swiszczoo/adat_usb_interface/gfx/overlay.png

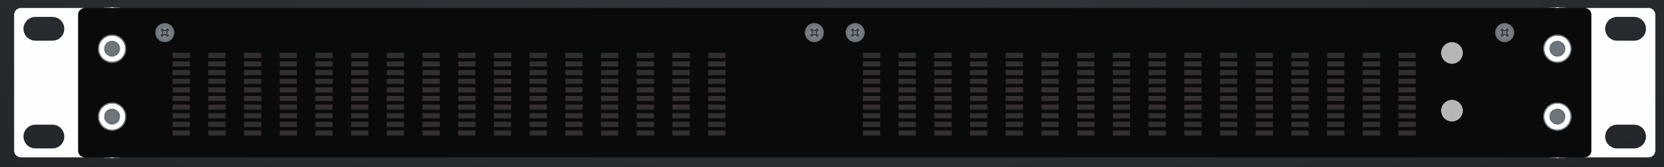
gfx/overlay.png
