swiszczoo/adat_usb_interface/cad/assembly.FCStd

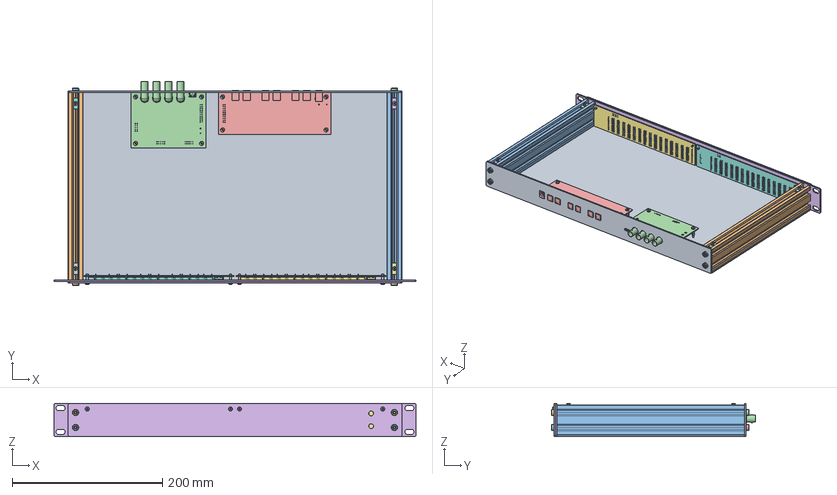
[picture p2: CAD file, 2025-11-25]
cad/assembly.FCStd
482.6 x 272.0 x 44.5 mm
bottom
vslot_2040_vslot_2040_250_001
vslot_2040_vslot_2040_250_002
tee_nut_Tee Nut_001
tee_nut_Tee Nut_002
tee_nut_Tee Nut_003
tee_nut_Tee Nut_004
M3x8-Śruba
M3x8-Śruba_001
M3x8-Śruba_002
M3x8-Śruba_003
spacer_10+6_spacer_10+6_001
spacer_10+6_spacer_10+6_002
spacer_10+6_spacer_10+6_003
spacer_10+6_spacer_10+6_004
spacer_10+6_spacer_10+6_005
spacer_10+6_spacer_10+6_006
spacer_10+6_spacer_10+6_007
spacer_10+6_spacer_10+6_008
main-board_001
supply-board_001
M3x8-Śruba001_001
M3x8-Śruba001_002
M3x8-Śruba001_003
M3x8-Śruba001_004
M3x8-Śruba001_005
M3x8-Śruba001_006
M3x8-Śruba001_007
M3x8-Śruba001_008
tee_nut_Tee Nut_005
tee_nut_Tee Nut_006
tee_nut_Tee Nut_007
tee_nut_Tee Nut_008
M3x8-Śruba_004
M3x8-Śruba_005
M3x8-Śruba_006
M3x8-Śruba_007
front_plate_front_plate_001
display-board_001
display-board_002
back_plate
M5x16-Śruba
M5x16-Śruba_001
M5x16-Śruba_002
M5x16-Śruba_003
front_acrylic
M5x16-Śruba_004
M5x16-Śruba_005
M5x16-Śruba_006
M5x16-Śruba_007
M3x12-Śruba_001
M3x12-Śruba_002
M3x12-Śruba_003
M3x12-Śruba_004
