swiszczoo/adat_usb_interface/cad/main-board.FCStd

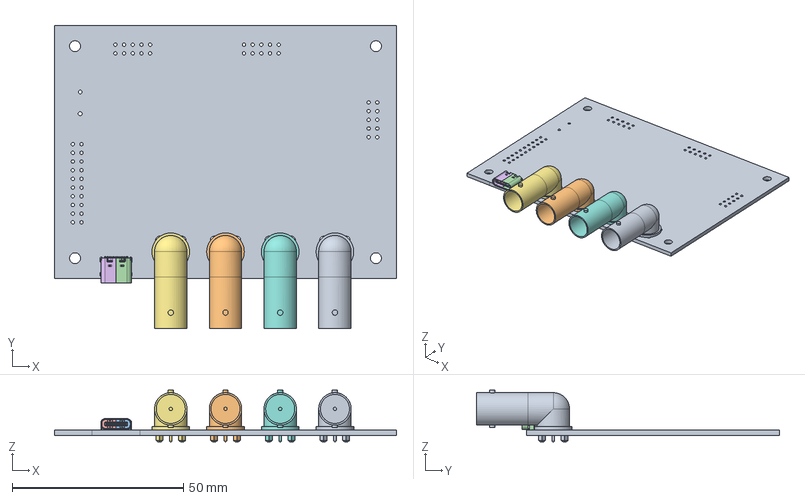
[picture p3: CAD file, 2025-11-04]
cad/main-board.FCStd
100.0 x 88.5 x 15.2 mm
DOSIN_801_0051
DOSIN_801_0052
USB_C_Receptacle_GCT_USB4105-xx-A_16P_TopMnt_Horizontal
USB_C_Receptacle_GCT_USB4105-xx-A_16P_TopMnt_Horizontal001
USB_C_Receptacle_GCT_USB4105-xx-A_16P_TopMnt_Horizontal002
USB_C_Receptacle_GCT_USB4105-xx-A_16P_TopMnt_Horizontal003
USB_C_Receptacle_GCT_USB4105-xx-A_16P_TopMnt_Horizontal004
USB_C_Receptacle_GCT_USB4105-xx-A_16P_TopMnt_Horizontal005
USB_C_Receptacle_GCT_USB4105-xx-A_16P_TopMnt_Horizontal006
USB_C_Receptacle_GCT_USB4105-xx-A_16P_TopMnt_Horizontal007
USB_C_Receptacle_GCT_USB4105-xx-A_16P_TopMnt_Horizontal008
USB_C_Receptacle_GCT_USB4105-xx-A_16P_TopMnt_Horizontal009
USB_C_Receptacle_GCT_USB4105-xx-A_16P_TopMnt_Horizontal010
USB_C_Receptacle_GCT_USB4105-xx-A_16P_TopMnt_Horizontal011
USB_C_Receptacle_GCT_USB4105-xx-A_16P_TopMnt_Horizontal012
USB_C_Receptacle_GCT_USB4105-xx-A_16P_TopMnt_Horizontal013
USB_C_Receptacle_GCT_USB4105-xx-A_16P_TopMnt_Horizontal014
USB_C_Receptacle_GCT_USB4105-xx-A_16P_TopMnt_Horizontal015
USB_C_Receptacle_GCT_USB4105-xx-A_16P_TopMnt_Horizontal016
USB_C_Receptacle_GCT_USB4105-xx-A_16P_TopMnt_Horizontal017
USB_C_Receptacle_GCT_USB4105-xx-A_16P_TopMnt_Horizontal018
USB_C_Receptacle_GCT_USB4105-xx-A_16P_TopMnt_Horizontal019
USB_C_Receptacle_GCT_USB4105-xx-A_16P_TopMnt_Horizontal020
USB_C_Receptacle_GCT_USB4105-xx-A_16P_TopMnt_Horizontal021
USB_C_Receptacle_GCT_USB4105-xx-A_16P_TopMnt_Horizontal022
USB_C_Receptacle_GCT_USB4105-xx-A_16P_TopMnt_Horizontal023
USB_C_Receptacle_GCT_USB4105-xx-A_16P_TopMnt_Horizontal024
USB_C_Receptacle_GCT_USB4105-xx-A_16P_TopMnt_Horizontal025
USB_C_Receptacle_GCT_USB4105-xx-A_16P_TopMnt_Horizontal026
USB_C_Receptacle_GCT_USB4105-xx-A_16P_TopMnt_Horizontal027
USB_C_Receptacle_GCT_USB4105-xx-A_16P_TopMnt_Horizontal028
USB_C_Receptacle_GCT_USB4105-xx-A_16P_TopMnt_Horizontal029
USB_C_Receptacle_GCT_USB4105-xx-A_16P_TopMnt_Horizontal030
USB_C_Receptacle_GCT_USB4105-xx-A_16P_TopMnt_Horizontal031
USB_C_Receptacle_GCT_USB4105-xx-A_16P_TopMnt_Horizontal032
USB_C_Receptacle_GCT_USB4105-xx-A_16P_TopMnt_Horizontal033
USB_C_Receptacle_GCT_USB4105-xx-A_16P_TopMnt_Horizontal034
USB_C_Receptacle_GCT_USB4105-xx-A_16P_TopMnt_Horizontal035
DOSIN_801_0053
DOSIN_801_0054
main-board_PCB
