swiszczoo/adat_usb_interface/cad/bottom_plate.FCStd

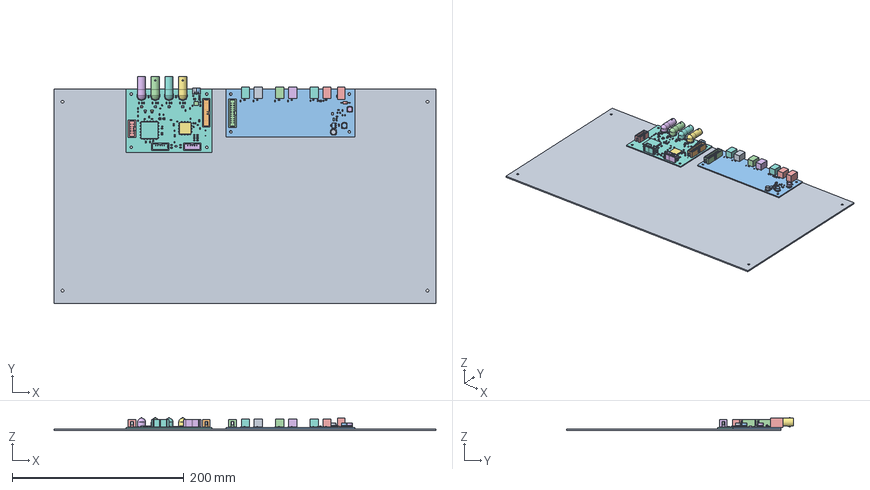
[picture p4: CAD file, 2025-11-25]
cad/bottom_plate.FCStd
445.0 x 264.5 x 15.2 mm
bottom_plate
C_0805_2012Metric
C_Elec_6.3x5.4
C_Elec_6.3x5.005
C_0805_2012Metric001
C_0805_2012Metric002
SOT-23-6
C_1206_3216Metric
L_1210_3225Metric
C_0805_2012Metric003
R_0805_2012Metric
R_0805_2012Metric001
CUI_PJ002A
C_Elec_6.3x5.007
C_Elec_6.3x5.008
PLx237
C_0805_2012Metric004
C_0805_2012Metric005
SOT-223
C_0805_2012Metric006
C_0805_2012Metric007
L_0805_2012Metric
R_0805_2012Metric002
R_0805_2012Metric003
R_0805_2012Metric004
R_0805_2012Metric005
C_0805_2012Metric008
IDC-Header_2x10_P2.54mm_Vertical
PLx238
C_1206_3216Metric001
L_0805_2012Metric001
PLx239
PLx240
C_1206_3216Metric002
SOT-563
PLx241
D_DO-41_SOD81_P10.16mm_Horizontal
PLx242
R_0805_2012Metric006
C_0805_2012Metric009
C_Elec_6.3x5.010
C_Elec_6.3x5.011
supply-board_PCB
C_0805_2012Metric010
C_0805_2012Metric011
R_0805_2012Metric007
R_0805_2012Metric008
IDC-Header_2x05_P2.54mm_Vertical
R_0805_2012Metric009
R_0805_2012Metric010
R_0805_2012Metric011
SOT-23-007
LED_0805_2012Metric
DOSIN_801_0051
R_0805_2012Metric012
DOSIN_801_0052
C_1206_3216Metric003
R_0805_2012Metric013
SOT-23-008
C_0805_2012Metric012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
