swiszczoo/adat_usb_interface/cad/back_plate.FCStd

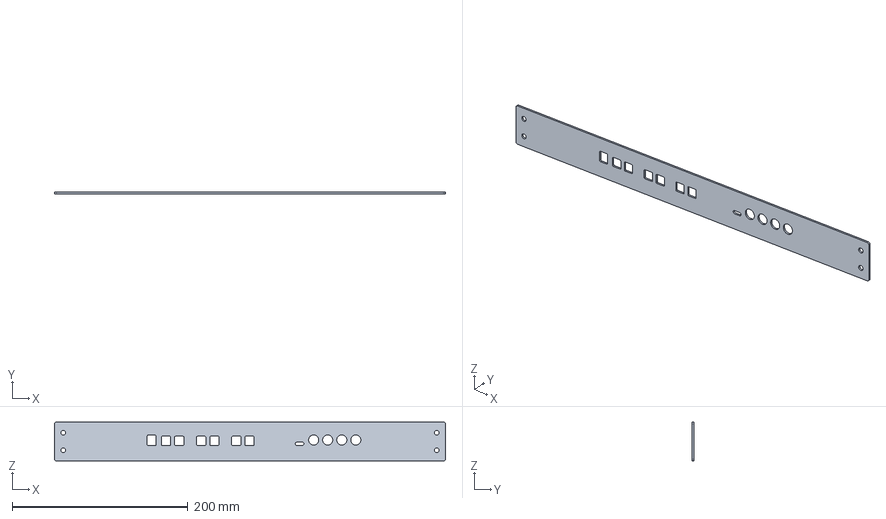
[picture p5: CAD file, 2025-11-25]
cad/back_plate.FCStd
445.0 x 2.00 x 44.0 mm
