swiszczoo/adat_usb_interface/cad/step/display-board.step

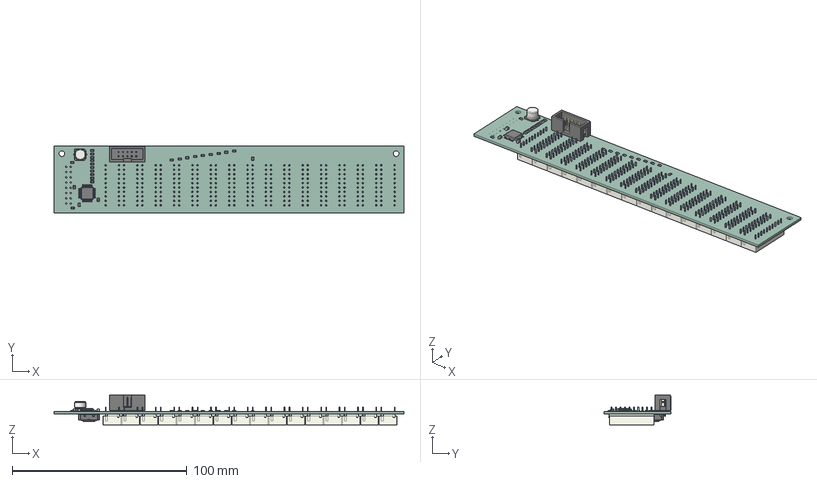
[picture p6: CAD file, 2025-11-04]
cad/step/display-board.step
200.0 x 38.5 x 16.9 mm
R_0805_2012Metric x 22
C_0805_2012Metric x 3
IDC-Header_2x05_P2.54mm_Vertical
C_Elec_6.3x5.4
LQFP-64_7x7mm_P0.4mm
HDSP-4832 x 16
SW_Push_1P1T_NO_CK_PTS125Sx43SMTR x 2
display-board_PCB
