swiszczoo/adat_usb_interface/cad/step/V-Slot 20x40x500 Linear Rail.step

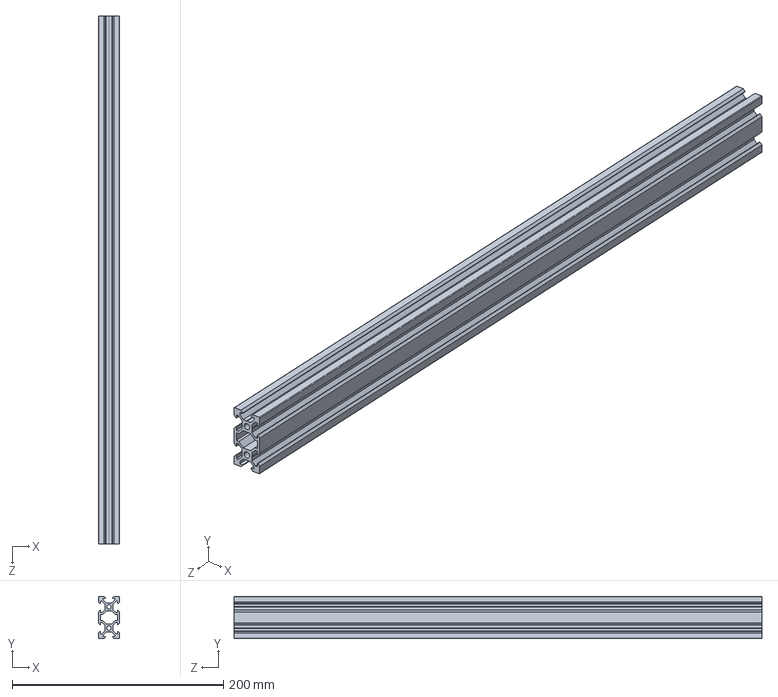
[picture p7: CAD file, 2025-11-04]
cad/step/V-Slot 20x40x500 Linear Rail.step
20.0 x 40.0 x 500.0 mm
