swiszczoo/adat_usb_interface/cad/front_plate.FCStd

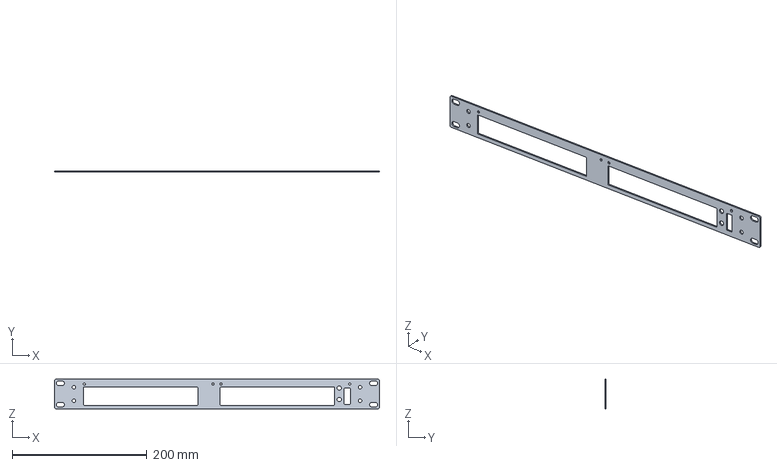
[picture p8: CAD file, 2025-11-25]
cad/front_plate.FCStd
482.6 x 2.00 x 44.0 mm
