swiszczoo/adat_usb_interface/cad/step/supply-board.step

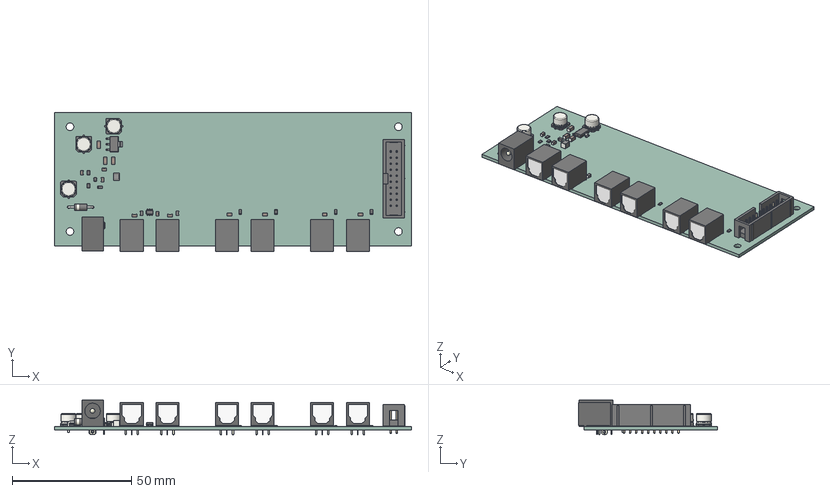
[picture p9: CAD file, 2025-11-04]
cad/step/supply-board.step
150.0 x 58.4 x 14.6 mm
C_0805_2012Metric x 10
C_Elec_6.3x5.4 x 3
SOT-23-6
C_1206_3216Metric x 3
L_1210_3225Metric
R_0805_2012Metric x 7
CUI_PJ002A
PLx237 x 6
SOT-223
L_0805_2012Metric x 2
IDC-Header_2x10_P2.54mm_Vertical
SOT-563
D_DO-41_SOD81_P10.16mm_Horizontal
supply-board_PCB
