swiszczoo/adat_usb_interface/cad/front_acrylic.FCStd

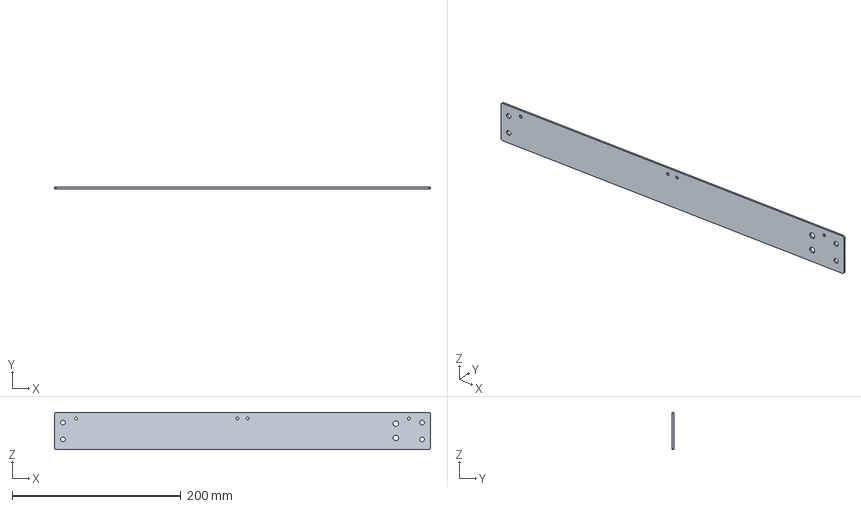
[picture p10: CAD file, 2025-11-25]
cad/front_acrylic.FCStd
445.0 x 2.00 x 44.0 mm
