swiszczoo/adat_usb_interface/cad/step/PLx237.step

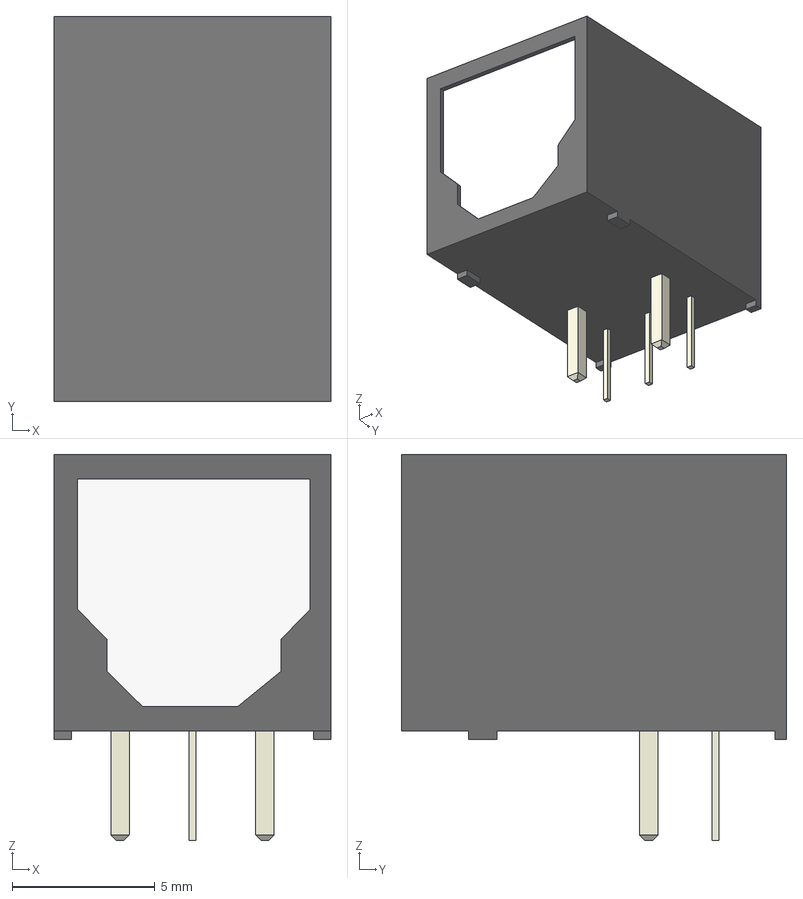
[picture p11: CAD file, 2025-10-09]
cad/step/PLx237.step
9.70 x 13.5 x 13.6 mm
