swiszczoo/adat_usb_interface/cad/step/DOSIN_801_0051.step

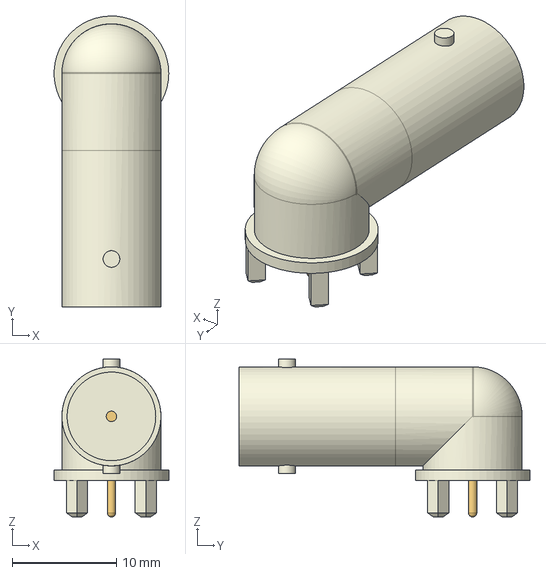
[picture p12: CAD file, 2025-10-09]
cad/step/DOSIN_801_0051.step
11.0 x 27.9 x 15.2 mm
