swiszczoo/adat_usb_interface/cad/top_plate.FCStd

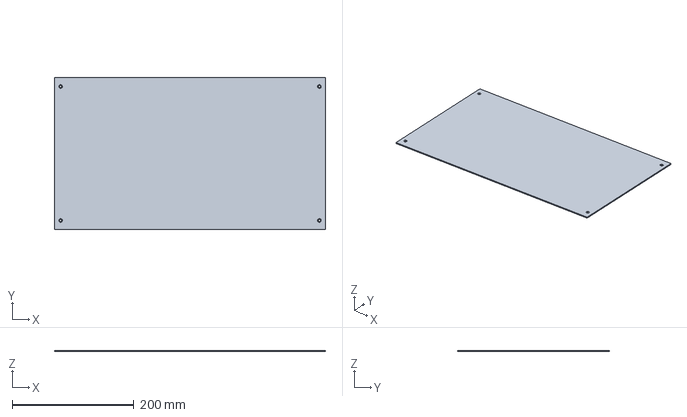
[picture p13: CAD file, 2025-11-04]
cad/top_plate.FCStd
445.0 x 250.0 x 2.00 mm
