swiszczoo/adat_usb_interface/cad/spacer_10+6.FCStd

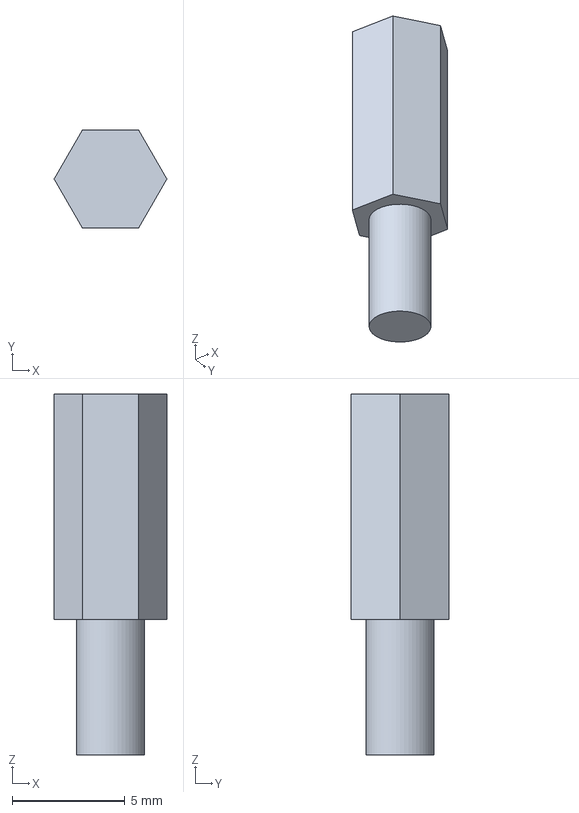
[picture p14: CAD file, 2025-11-04]
cad/spacer_10+6.FCStd
5.00 x 4.33 x 16.0 mm
