swiszczoo/adat_usb_interface/cad/step/CUI_PJ002A.step

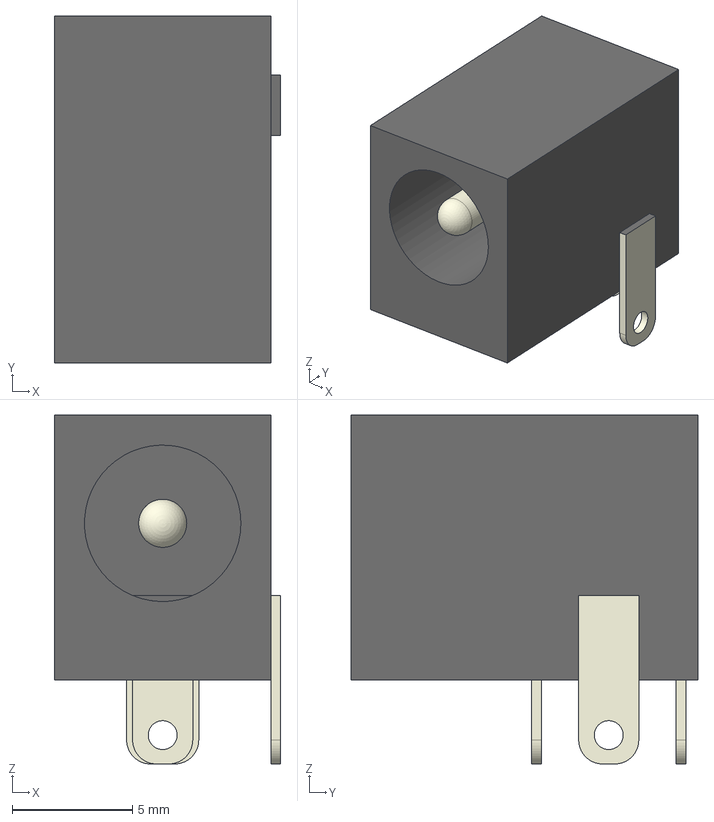
[picture p15: CAD file, 2025-10-09]
cad/step/CUI_PJ002A.step
9.40 x 14.4 x 14.5 mm
