swiszczoo/adat_usb_interface/cad/vslot_2040_250.FCStd

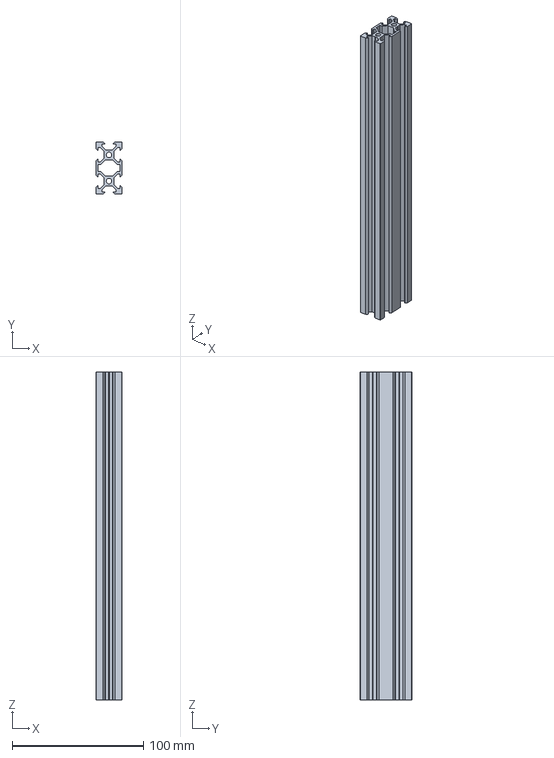
[picture p16: CAD file, 2025-11-04]
cad/vslot_2040_250.FCStd
20.0 x 40.0 x 250.0 mm
