swiszczoo/adat_usb_interface/cad/step/Tee Nut.step

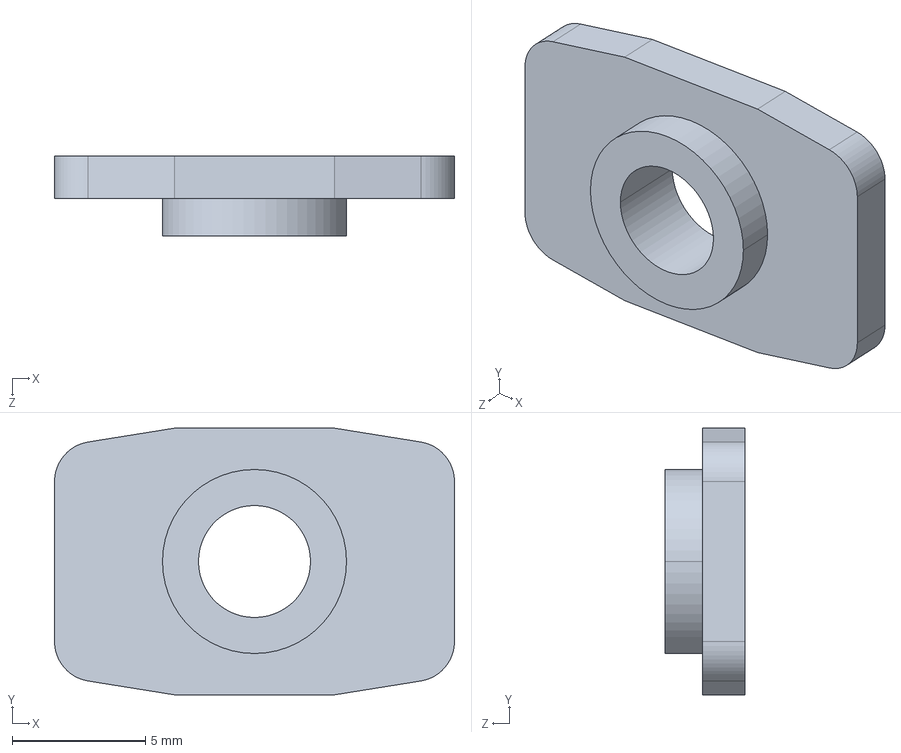
[picture p17: CAD file, 2025-11-04]
cad/step/Tee Nut.step
15.0 x 10.0 x 3.00 mm
