swiszczoo/adat_usb_interface/(list of files, cad)

Other CAD files:
cad/CUI_PJ002A.FCStd
cad/DOSIN_801_0051.FCStd
cad/PLx237.FCStd
cad/display-board.FCStd
cad/supply-board.FCStd
cad/tee_nut.FCStd
