swiszczoo/adat_usb_interface/pcb/pdf/adatv2.pdf

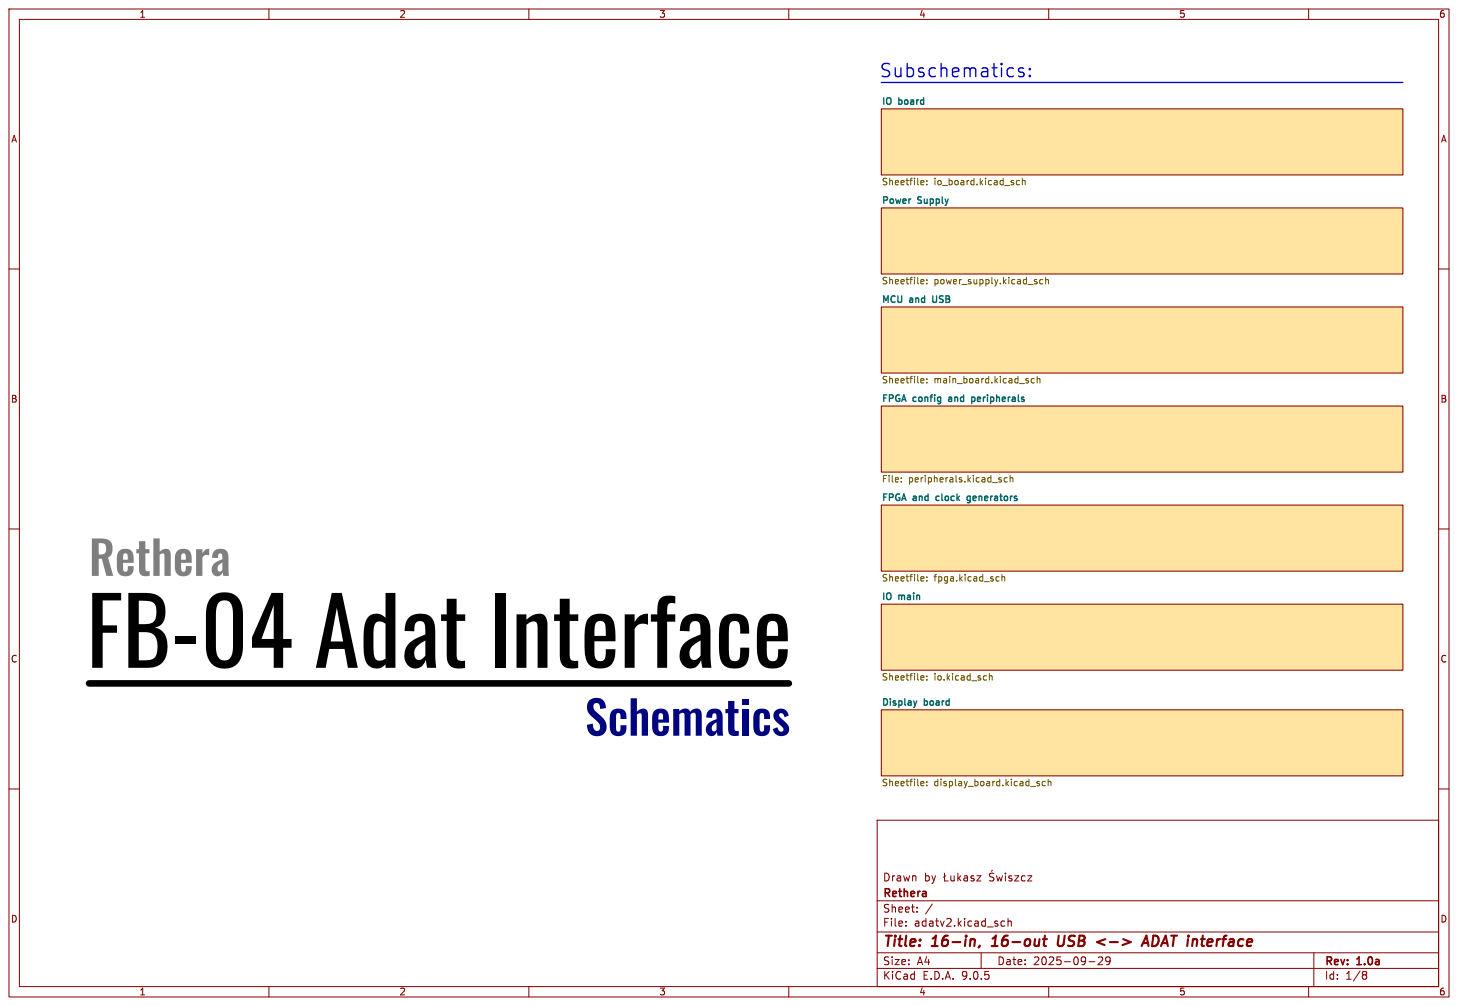
[picture p18: page 1]

FPGA config and peripherals File: peripherals.kicad_sch

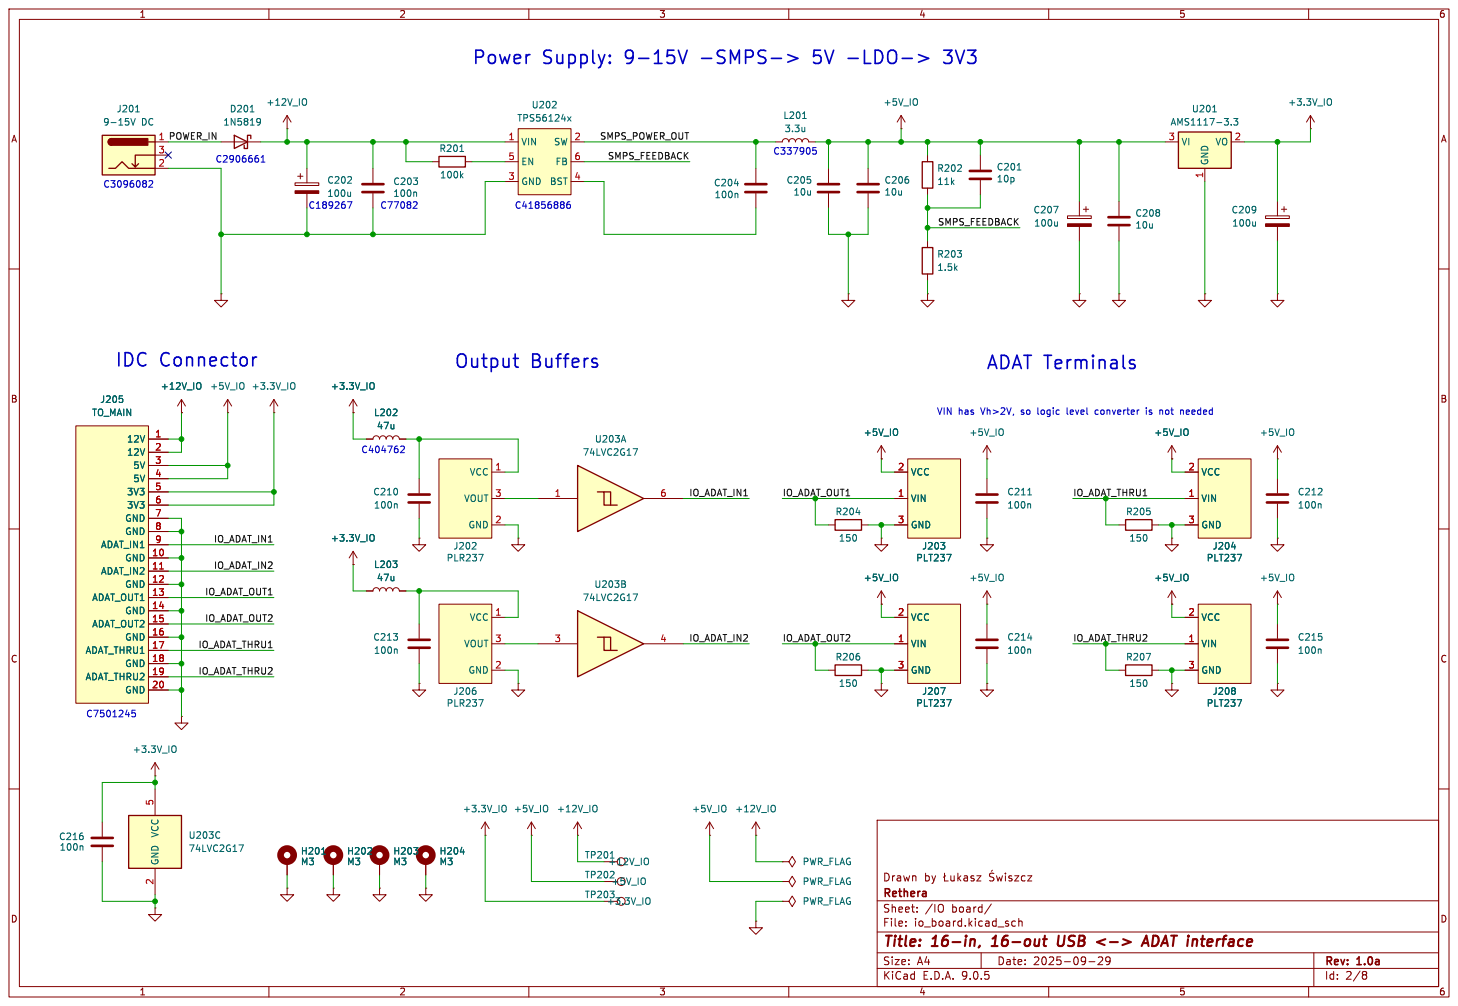
[picture p19: page 2]

3V3 6 GND 7 GND 8 ADAT_IN1 9 GND 10 ADAT_IN2 11 GND 12 ADAT_OUT1 13 GND 14 ADAT_OUT2 15 GND 16 ADAT_THRU1 17 GND 18 ADAT_THRU2 19 GND 20

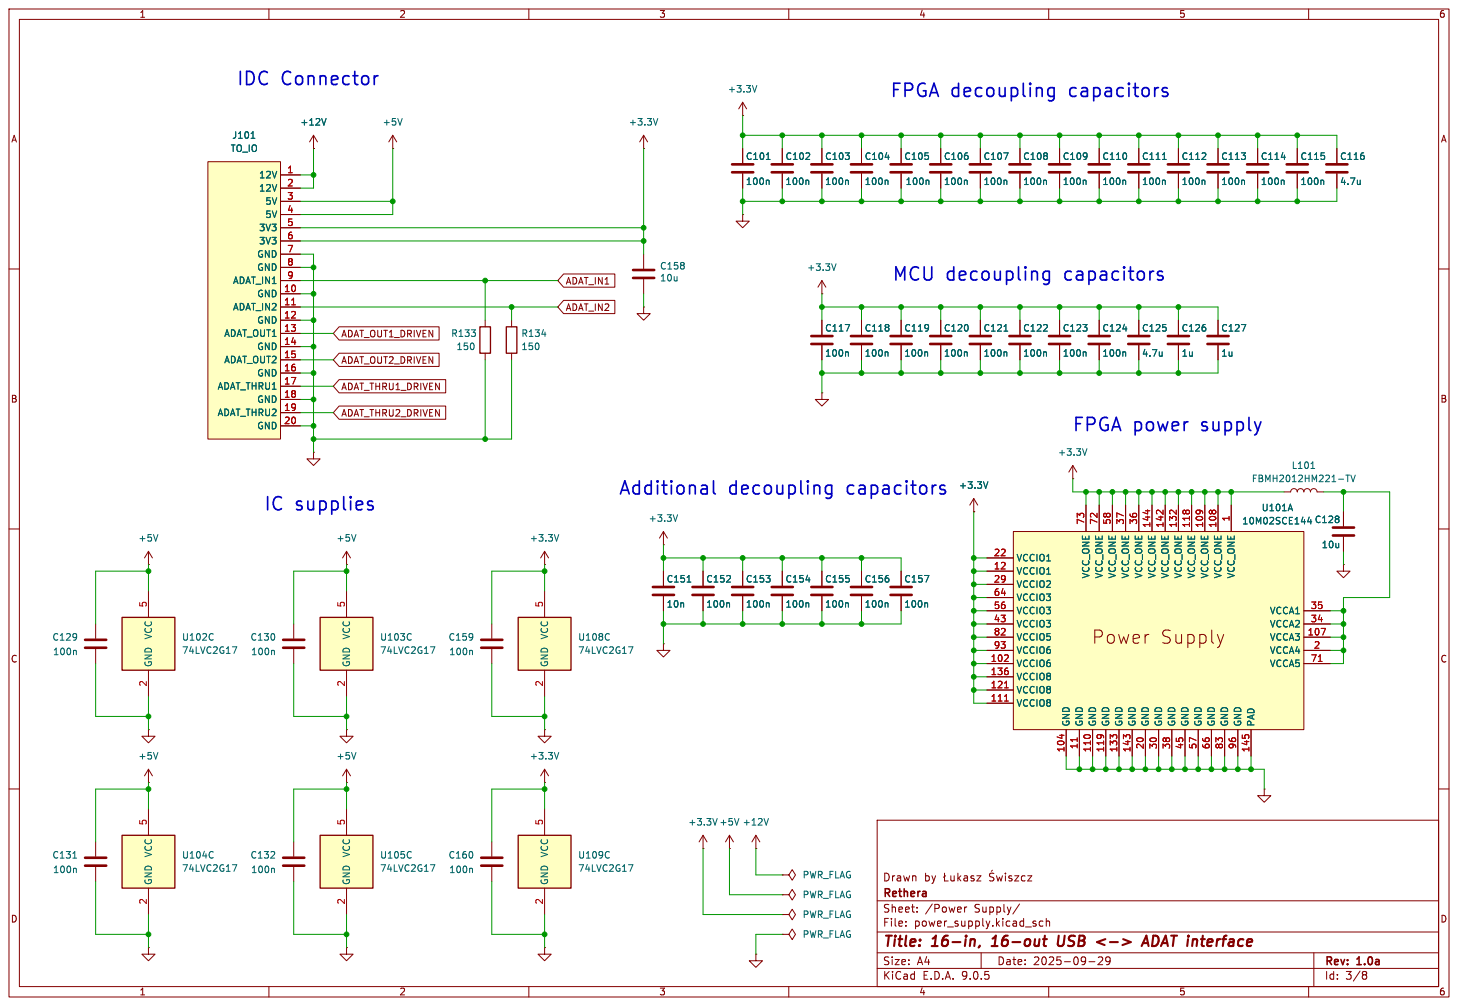
[picture p20: page 3]

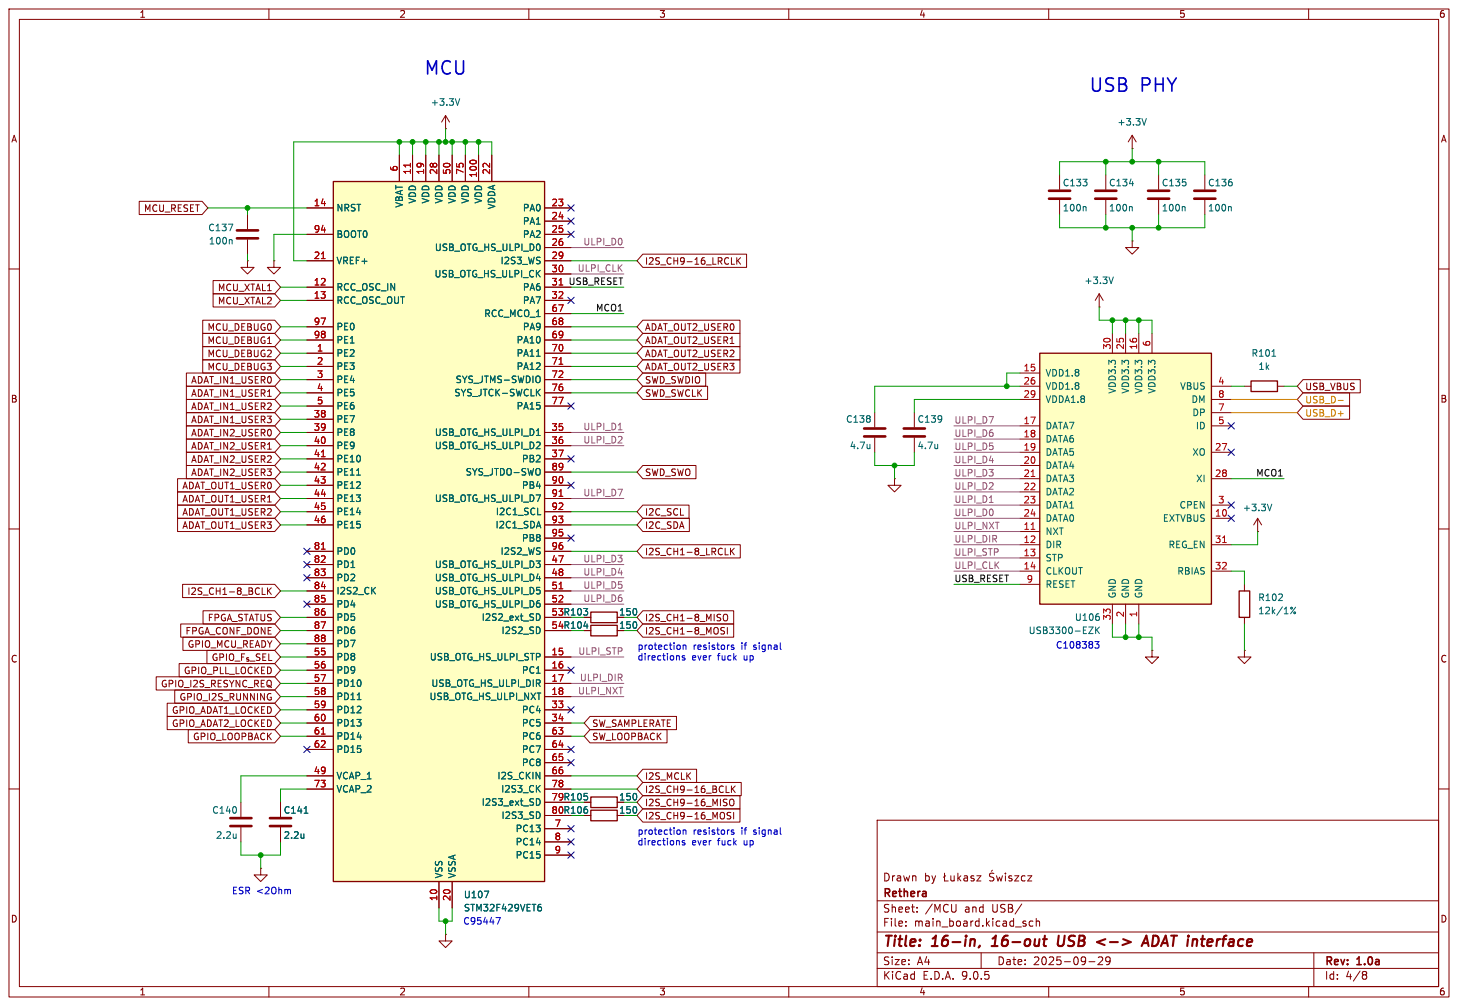
[picture p21: page 4]

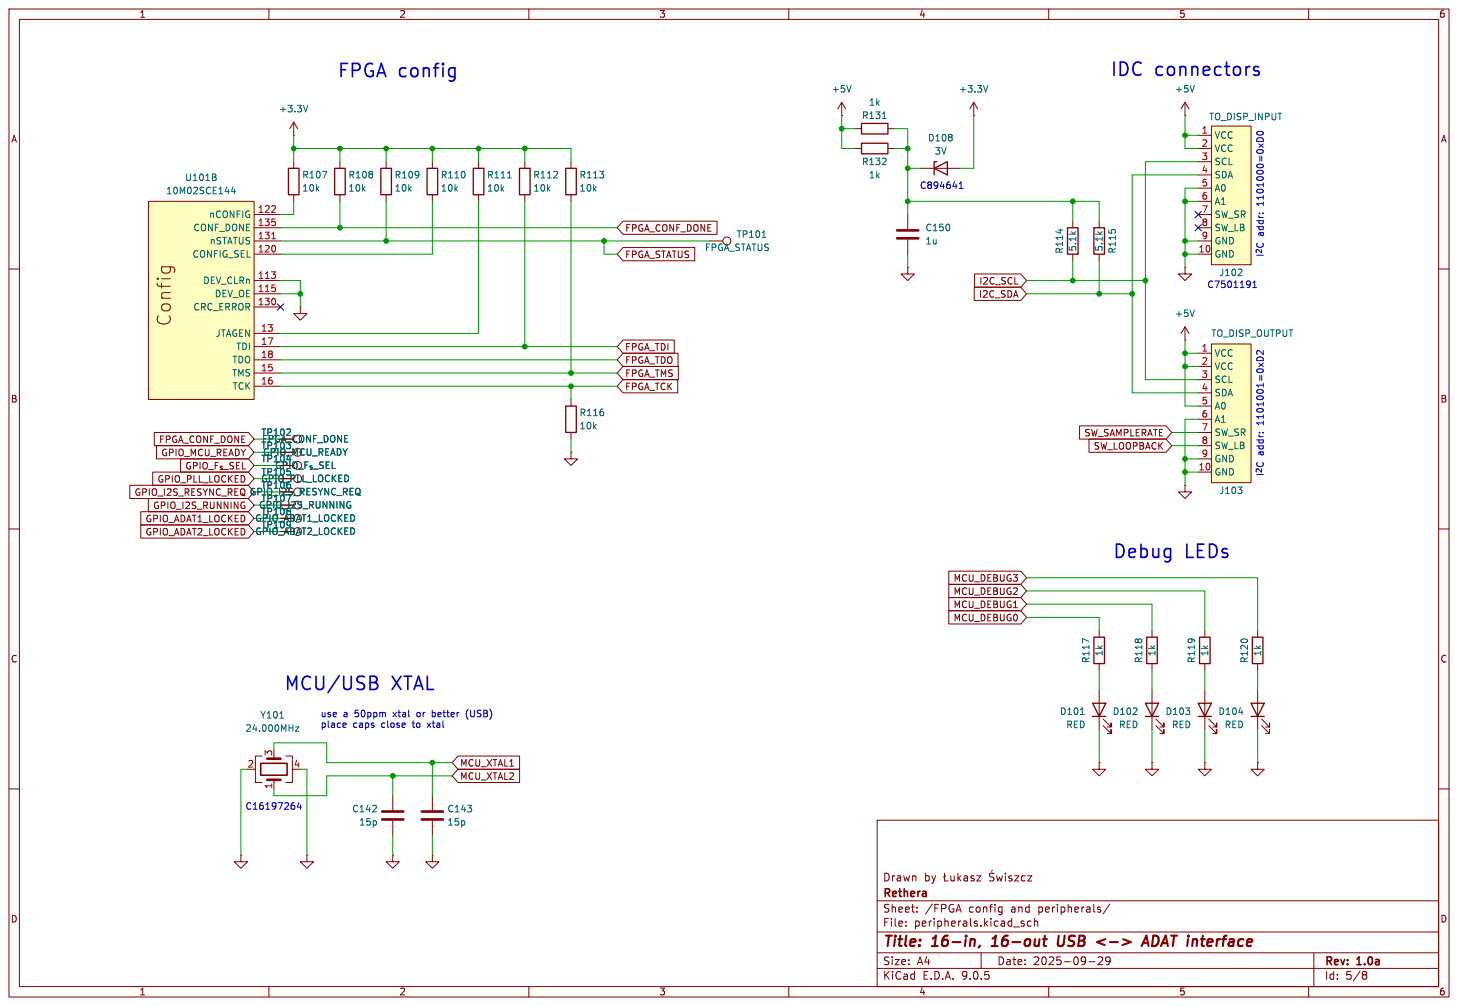
[picture p22: page 5]

use a 50ppm xtal or better (USB)

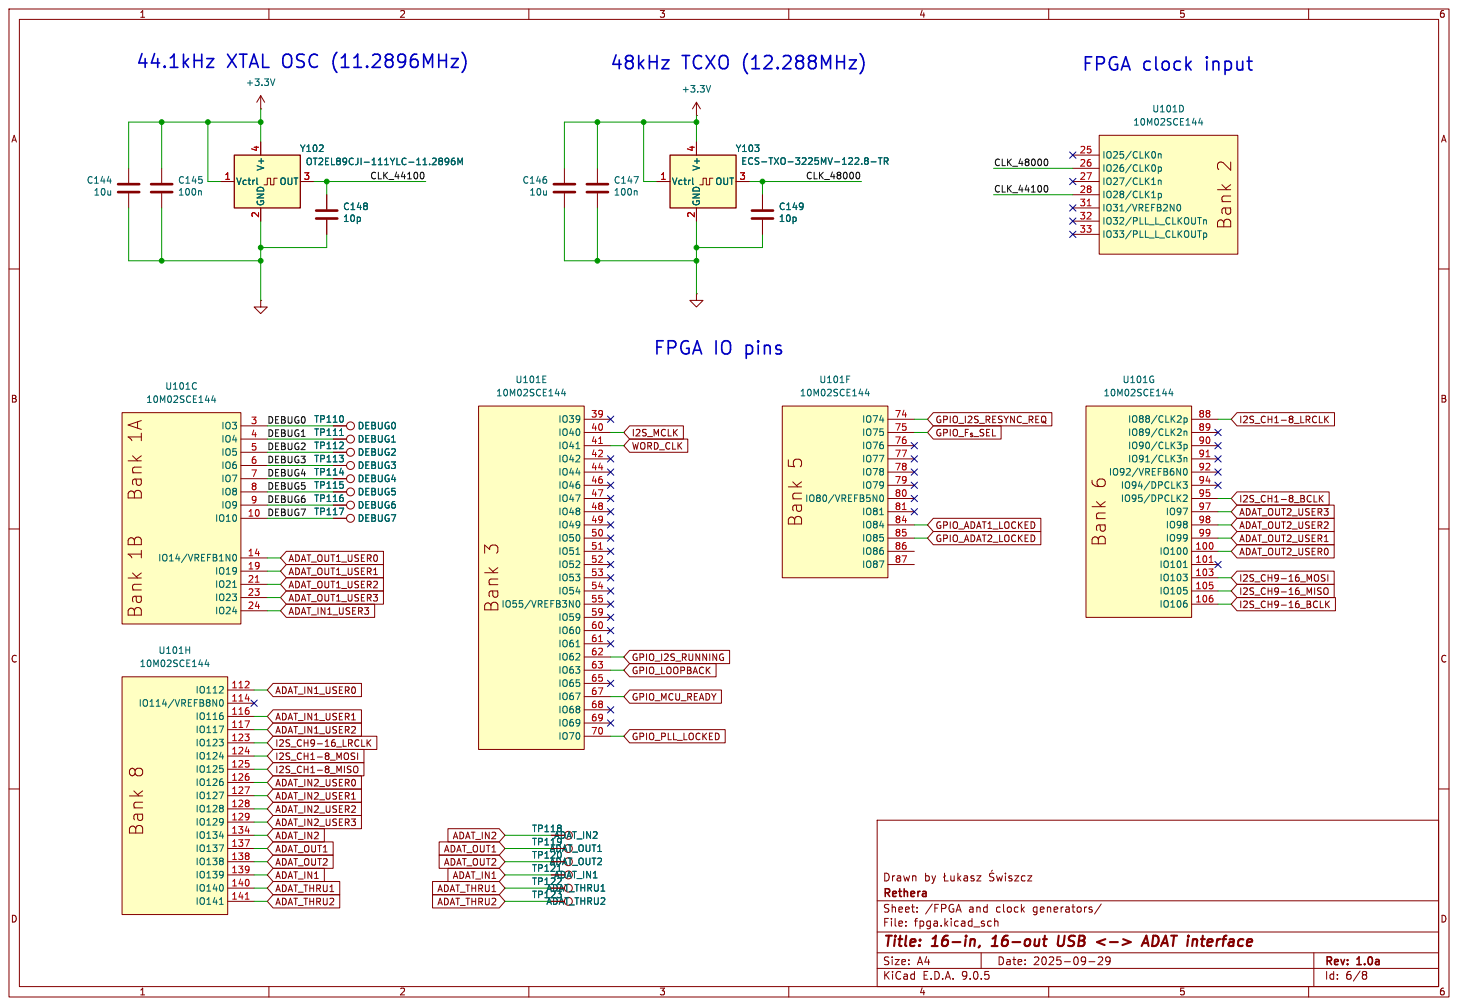
[picture p23: page 6]

2 OUT 3Y103 ECS-TXO-3225MV-122.8-TR

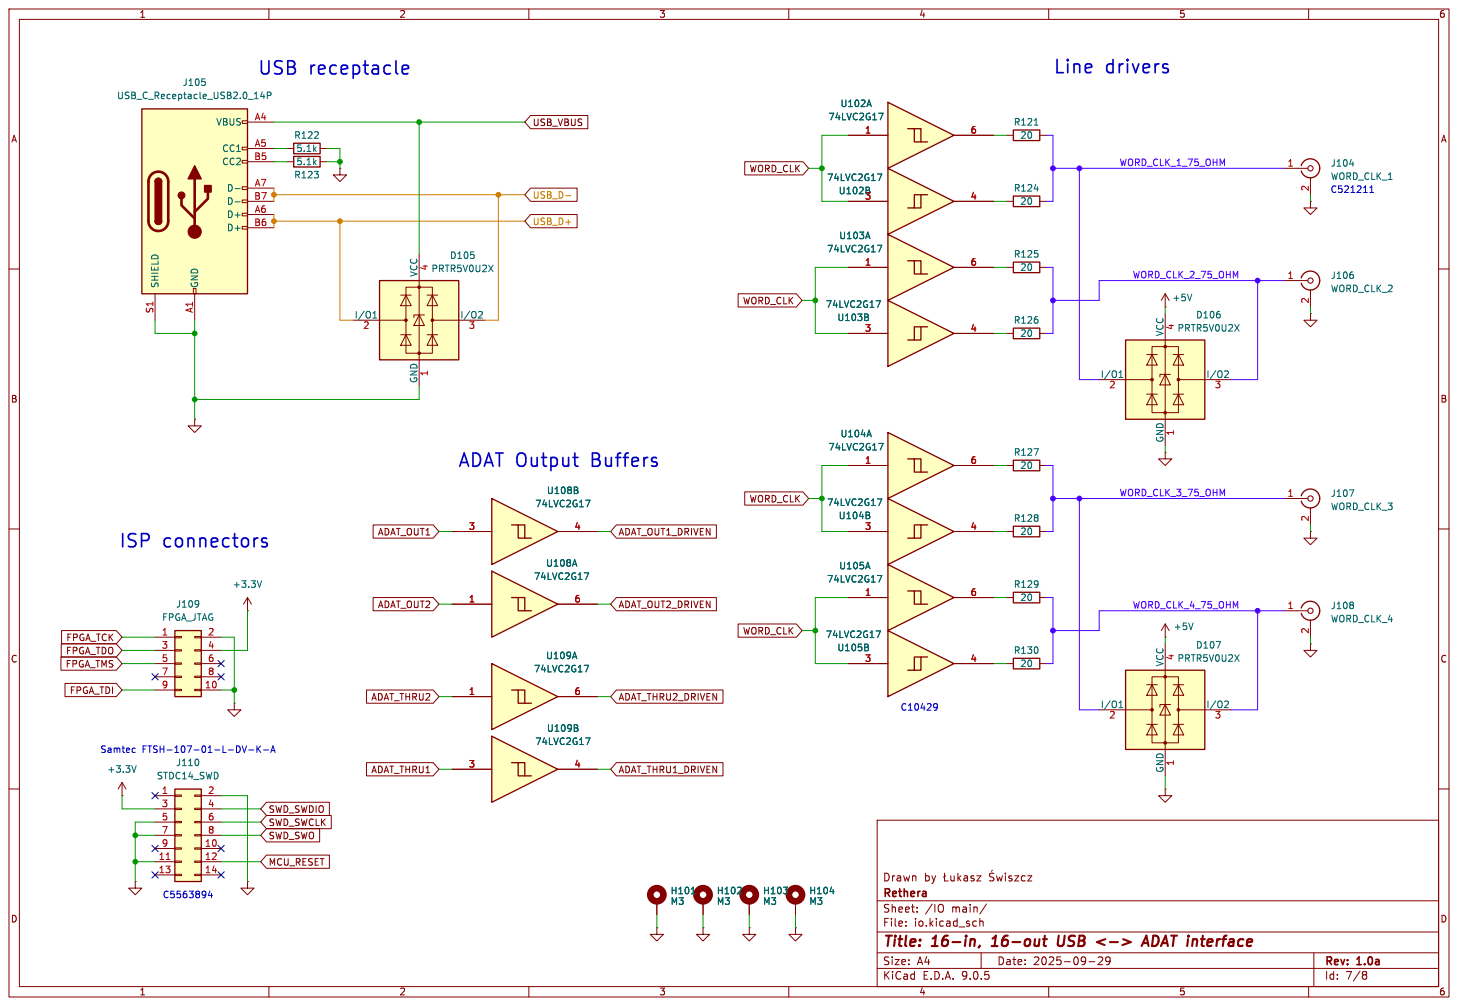
[picture p24: page 7]

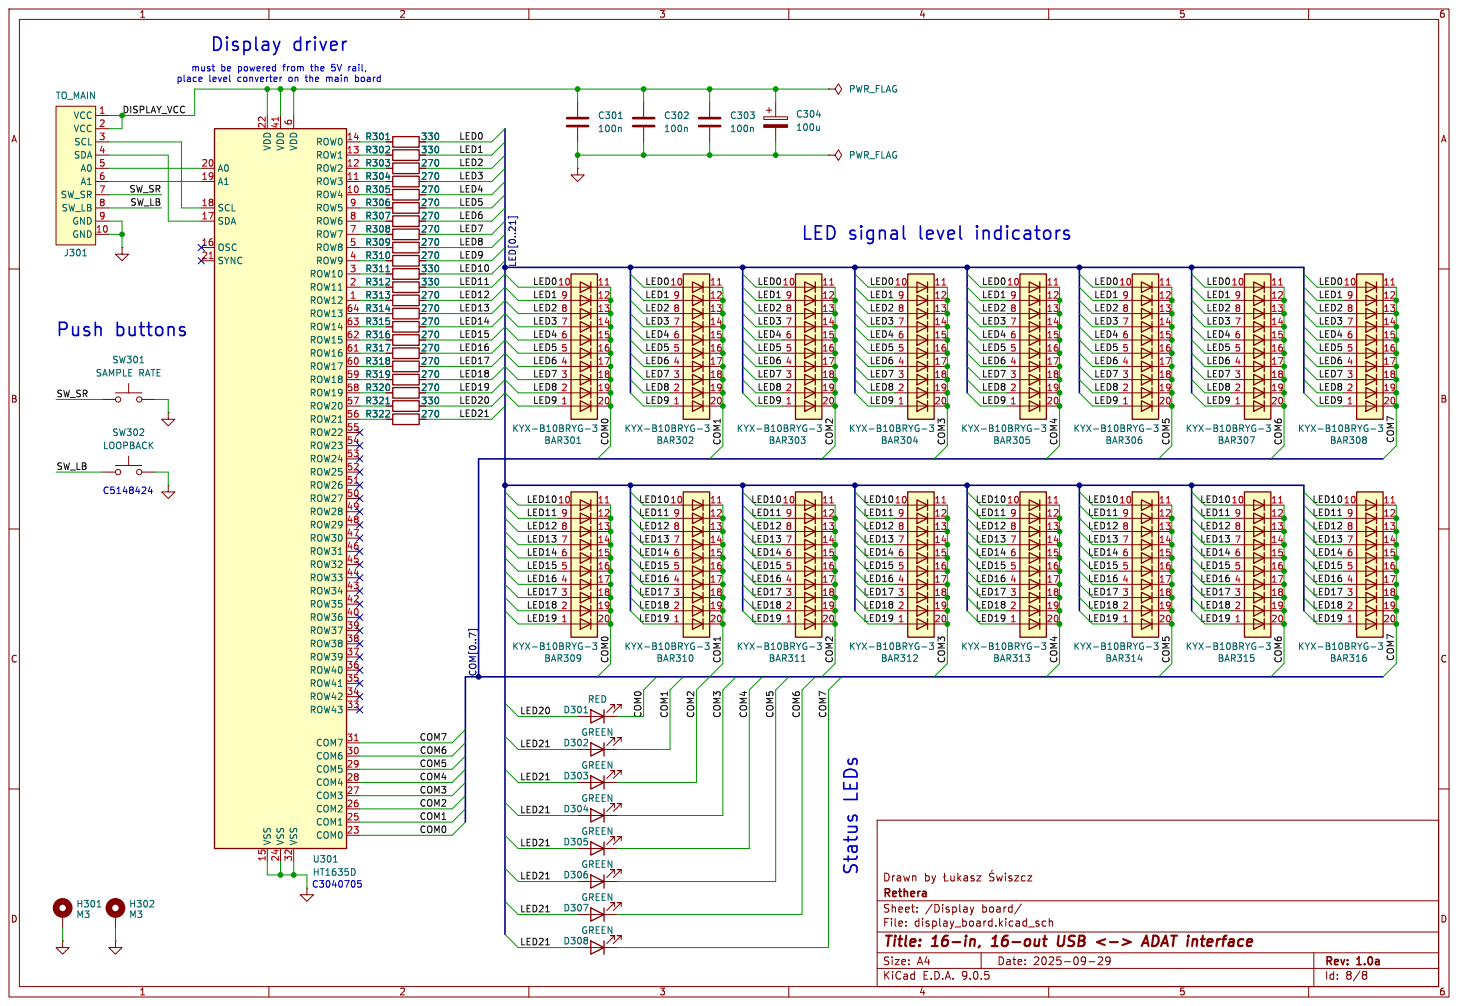
[picture p25: page 8]
