swiszczoo/adat_usb_interface/pcb/adatv2.kicad_pcb

## KiCad design pcb/adatv2.kicad_pcb (2025-10-10)

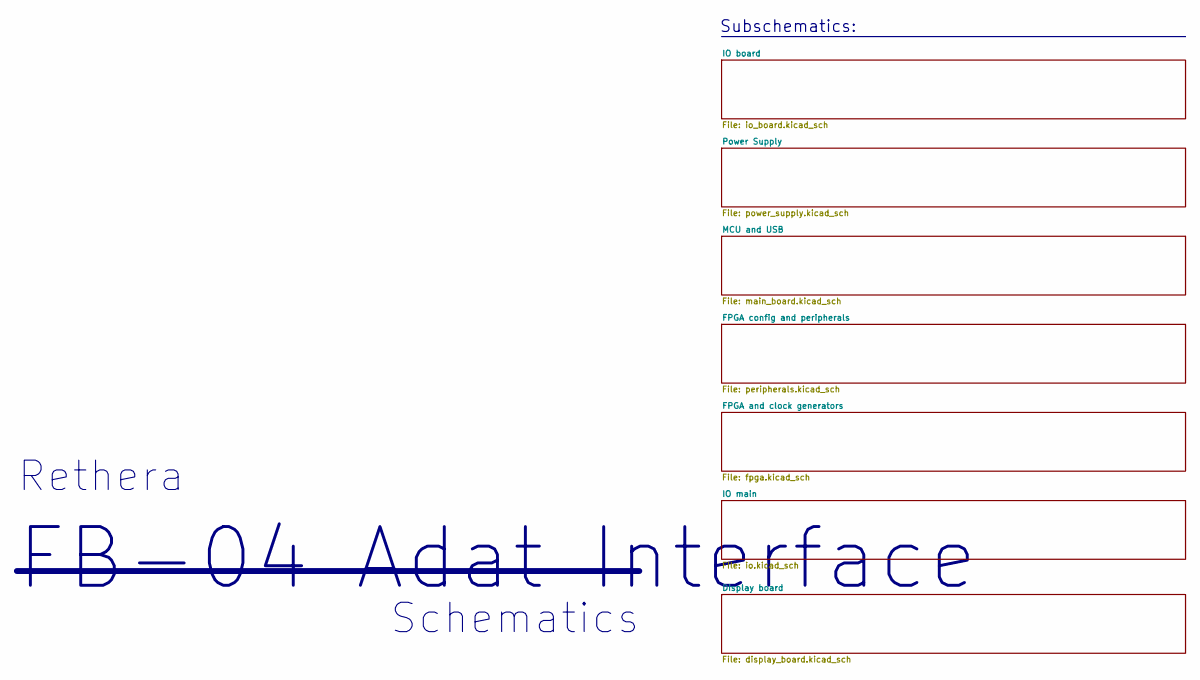
[picture p26: schematic adatv2.kicad_sch, 16-in, 16-out USB <-> ADAT interface]

Notes on the sheet:
Subschematics:
FB-04 Adat Interface
Schematics
Rethera

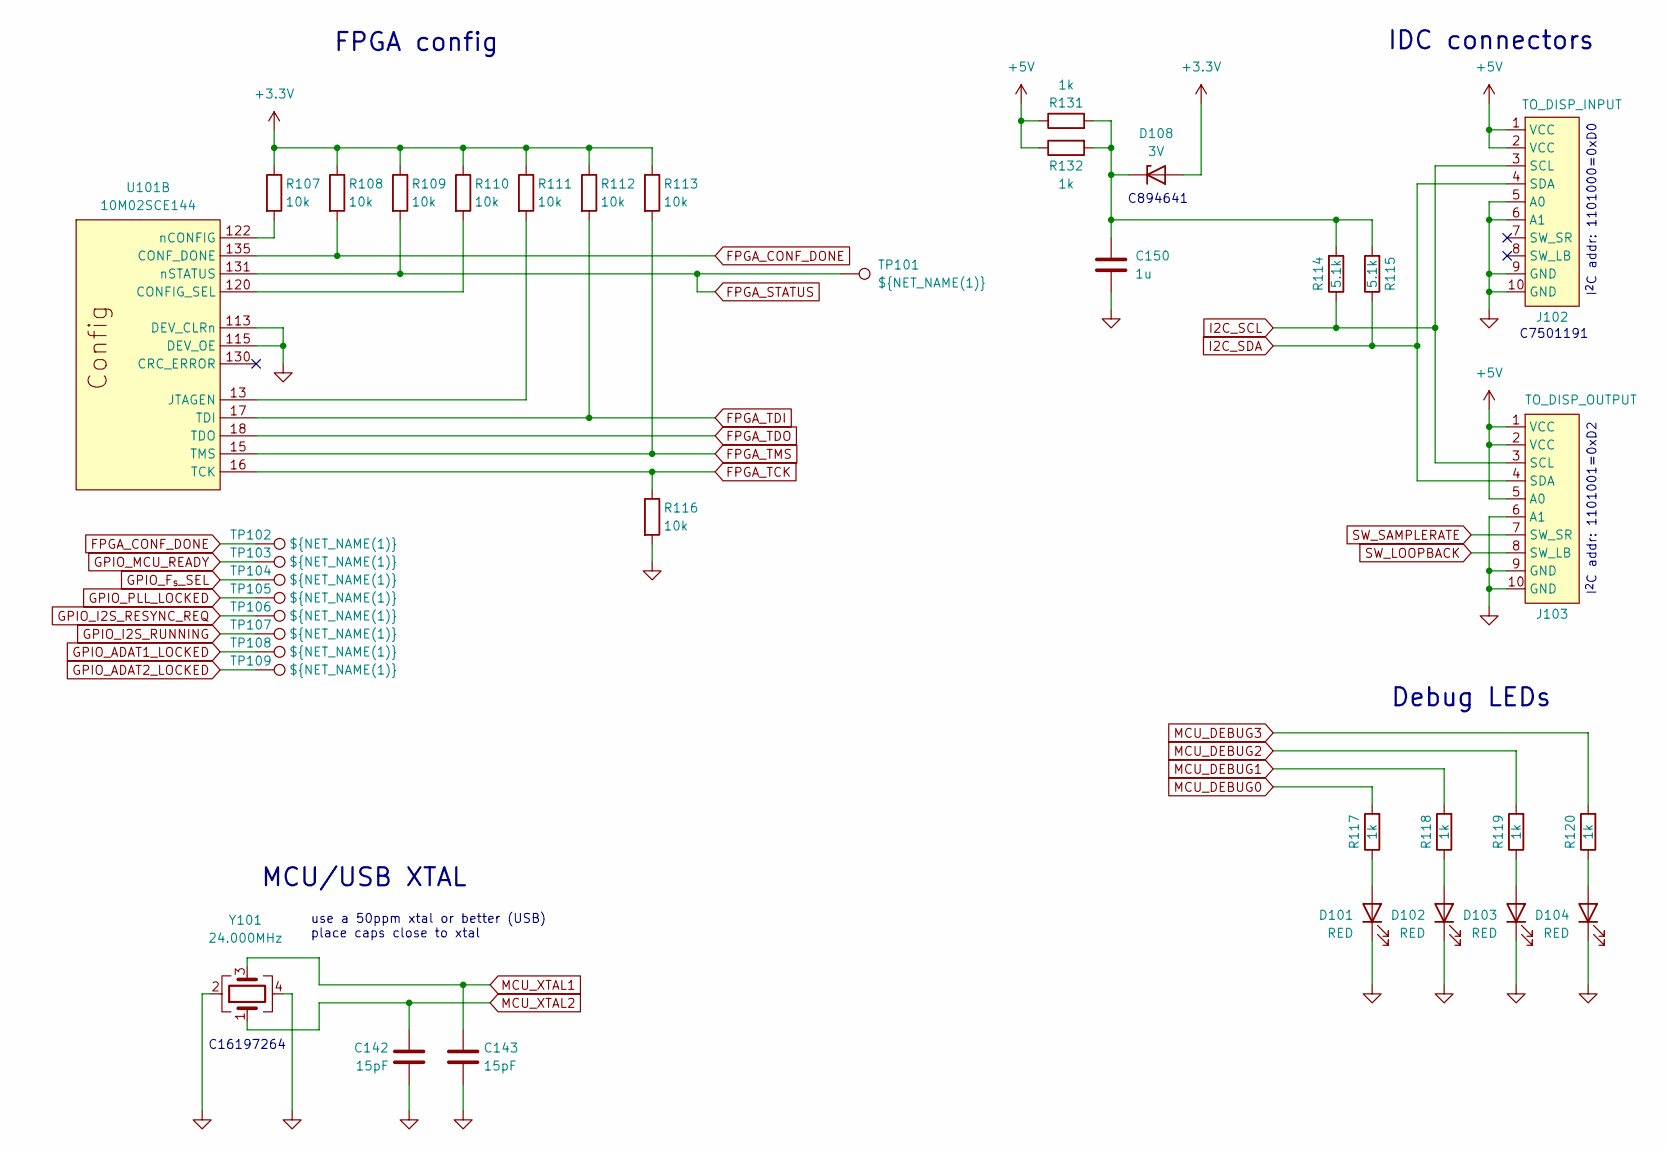
[picture p27: schematic peripherals.kicad_sch, 16-in, 16-out USB <-> ADAT interface]

Parts:
C142, C143: 15pF; C_0805_2012Metric_Pad1.18x1.45mm_HandSolder
C150: 1u; C_0805_2012Metric_Pad1.18x1.45mm_HandSolder
D101, D102, D103, D104: RED; LED_0805_2012Metric_Pad1.15x1.40mm_HandSolder
D108: 3V; D_SOD-123
J102: TO_DISP_INPUT; IDC-Header_2x05_P2.54mm_Vertical
J103: TO_DISP_OUTPUT; IDC-Header_2x05_P2.54mm_Vertical
R107, R108, R109, R110, R111, R112, R113, R116: 10k; R_0805_2012Metric_Pad1.20x1.40mm_HandSolder
R114, R115: 5.1k; R_0805_2012Metric_Pad1.20x1.40mm_HandSolder
R117, R118, R119, R120, R131, R132: 1k; R_0805_2012Metric_Pad1.20x1.40mm_HandSolder
TP101, TP102, TP103, TP104, TP105, TP106, TP107, TP108, TP109: ${NET_NAME(1)}; TestPoint_Pad_D2.5mm
U101: 10M02SCE144; EQFP-144-1EP_20x20mm_P0.5mm_EP4x4mm
Y101: 24.000MHz; Oscillator_SMD_Abracon_ASE-4Pin_3.2x2.5mm_HandSoldering

Connections:
+3.3V: D108.2 (A), R107.1, R108.1, R109.1, R110.1, R111.1, R112.1, R113.1; also elsewhere on the board
+5V: J102.1 (VCC), J102.2 (VCC), J103.1 (VCC), J103.2 (VCC), J103.5 (A0), R131.1, R132.1; also elsewhere on the board
FPGA_CONF_DONE: R108.2, TP102.1, U101.135 (CONF_DONE); also elsewhere on the board
FPGA_STATUS: R109.2, TP101.1, U101.131 (nSTATUS); also elsewhere on the board
FPGA_TCK: R116.1, U101.16 (TCK); also elsewhere on the board
FPGA_TDI: R112.2, U101.17 (TDI); also elsewhere on the board
FPGA_TDO: U101.18 (TDO); also elsewhere on the board
FPGA_TMS: R113.2, U101.15 (TMS); also elsewhere on the board
GND: C142.2, C143.2, C150.2, D101.1 (K), D102.1 (K), D103.1 (K), D104.1 (K), J102.5 (A0), J102.6 (A1), J102.9 (GND), J102.10 (GND), J103.6 (A1), J103.9 (GND), J103.10 (GND), R116.2, U101.113 (DEV_CLRn), U101.115 (DEV_OE), Y101.2, Y101.4; also elsewhere on the board
GPIO_ADAT1_LOCKED: TP108.1; also elsewhere on the board
GPIO_ADAT2_LOCKED: TP109.1; also elsewhere on the board
GPIO_F_{s}_SEL: TP104.1; also elsewhere on the board
GPIO_I2S_RESYNC_REQ: TP106.1; also elsewhere on the board
GPIO_I2S_RUNNING: TP107.1; also elsewhere on the board
GPIO_MCU_READY: TP103.1; also elsewhere on the board
GPIO_PLL_LOCKED: TP105.1; also elsewhere on the board
I2C_SCL: J102.3 (SCL), J103.3 (SCL), R114.1; also elsewhere on the board
I2C_SDA: J102.4 (SDA), J103.4 (SDA), R115.1; also elsewhere on the board
MCU_DEBUG0: R117.2; also elsewhere on the board
MCU_DEBUG1: R118.2; also elsewhere on the board
MCU_DEBUG2: R119.2; also elsewhere on the board
MCU_DEBUG3: R120.2; also elsewhere on the board
MCU_XTAL1: C143.1, Y101.3; also elsewhere on the board
MCU_XTAL2: C142.1, Y101.1; also elsewhere on the board
unnamed: D101.2 (A), R117.1
unnamed: D102.2 (A), R118.1
unnamed: D103.2 (A), R119.1
unnamed: D104.2 (A), R120.1
unnamed: C150.1, D108.1 (K), R114.2, R115.2, R131.2, R132.2
unnamed: R110.2, U101.120 (CONFIG_SEL)
unnamed: R111.2, U101.13 (JTAGEN)
unnamed: R107.2, U101.122 (nCONFIG)
SW_LOOPBACK: J103.8 (SW_LB); also elsewhere on the board
SW_SAMPLERATE: J103.7 (SW_SR); also elsewhere on the board

Notes on the sheet:
C16197264
FPGA config
Debug LEDs
C894641
MCU/USB XTAL
I^{2}C addr: 1101000=0xD0
use a 50ppm xtal or better (USB) place caps close to xtal
I^{2}C addr: 1101001=0xD2
C7501191
IDC connectors

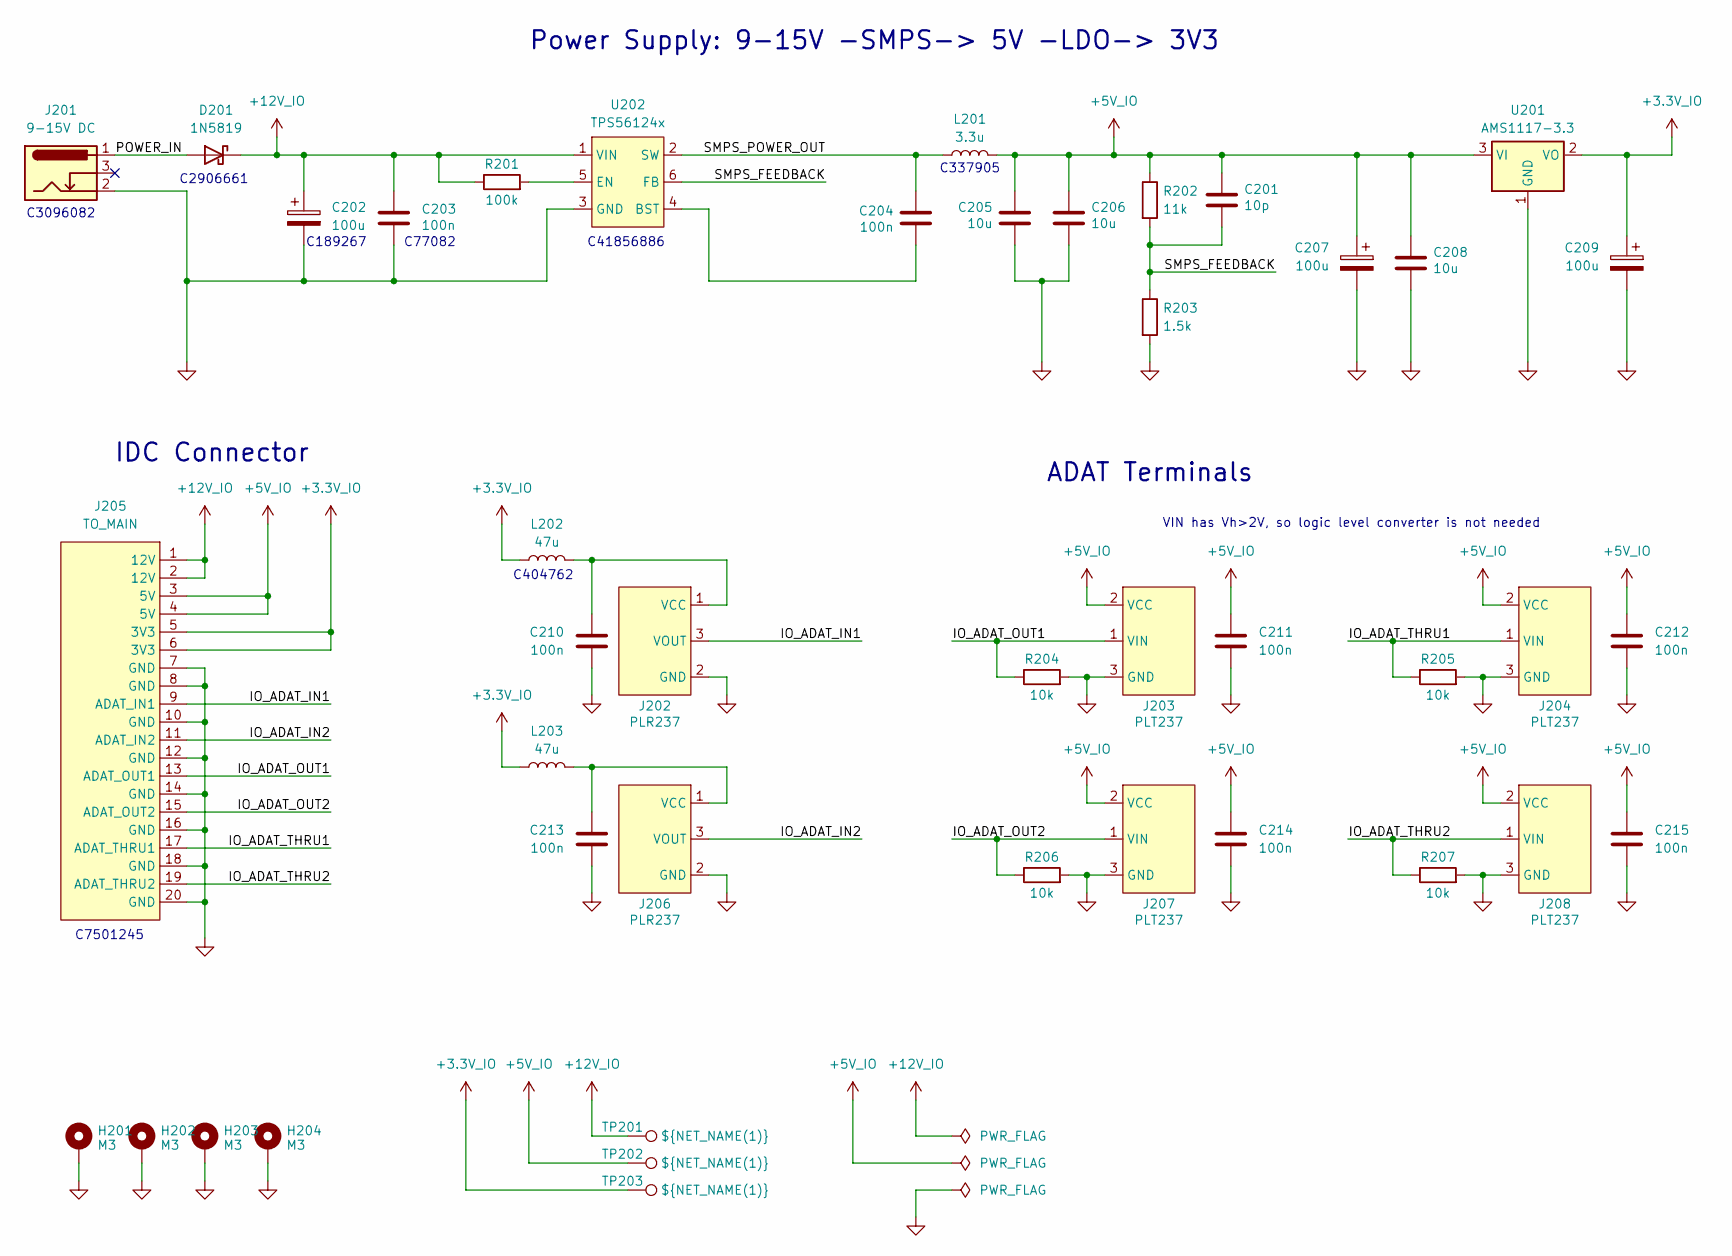
[picture p28: schematic io_board.kicad_sch, 16-in, 16-out USB <-> ADAT interface]

Parts:
C201: 10p; C_0805_2012Metric_Pad1.18x1.45mm_HandSolder
C202, C207, C209: 100u; C_Elec_6.3x5.4
C203, C204, C210, C211, C212, C213, C214, C215: 100n; C_0805_2012Metric_Pad1.18x1.45mm_HandSolder
C205, C206, C208: 10u; C_1206_3216Metric_Pad1.33x1.80mm_HandSolder
D201: 1N5819; D_DO-41_SOD81_P10.16mm_Horizontal
H201, H202, H203, H204: M3; MountingHole_3.2mm_M3_Pad
J201: 9-15V DC; CUI PJ-002A
J202, J206: PLR237; PLx237
J203, J204, J207, J208: PLT237; PLx237
J205: TO_MAIN; IDC-Header_2x10_P2.54mm_Vertical
L201: 3.3u; L_1210_3225Metric_Pad1.42x2.65mm_HandSolder
L202, L203: 47u; L_0805_2012Metric_Pad1.15x1.40mm_HandSolder
R201: 100k; R_0805_2012Metric_Pad1.20x1.40mm_HandSolder
R202: 11k; R_0805_2012Metric_Pad1.20x1.40mm_HandSolder
R203: 1.5k; R_0805_2012Metric_Pad1.20x1.40mm_HandSolder
R204, R205, R206, R207: 10k; R_0805_2012Metric_Pad1.20x1.40mm_HandSolder
TP201, TP202, TP203: ${NET_NAME(1)}; TestPoint_Pad_D2.5mm
U201: AMS1117-3.3; SOT-223-3_TabPin2
U202: TPS56124x; SOT-563

Connections:
+3.3V_IO: C209.1, J205.5 (3V3), J205.6 (3V3), L202.1, L203.1, TP203.1, U201.2 (VO)
+5V_IO: C201.1, C205.1, C206.1, C207.1, C208.1, C211.1, C212.1, C214.1, C215.1, J203.2 (VCC), J204.2 (VCC), J205.3 (5V), J205.4 (5V), J207.2 (VCC), J208.2 (VCC), L201.2, R202.1, TP202.1, U201.3 (VI)
+12V_IO: C202.1, C203.1, D201.1 (K), J205.1 (12V), J205.2 (12V), R201.1, TP201.1, U202.1 (VIN)
/IO board/IO_ADAT_IN1: J202.3 (VOUT), J205.9 (ADAT_IN1)
/IO board/IO_ADAT_IN2: J205.11 (ADAT_IN2), J206.3 (VOUT)
/IO board/IO_ADAT_OUT1: J203.1 (VIN), J205.13 (ADAT_OUT1), R204.1
/IO board/IO_ADAT_OUT2: J205.15 (ADAT_OUT2), J207.1 (VIN), R206.1
/IO board/IO_ADAT_THRU1: J204.1 (VIN), J205.17 (ADAT_THRU1), R205.1
/IO board/IO_ADAT_THRU2: J205.19 (ADAT_THRU2), J208.1 (VIN), R207.1
/IO board/POWER_IN: D201.2 (A), J201.1
/IO board/SMPS_FEEDBACK: C201.2, R202.2, R203.1, U202.6 (FB)
/IO board/SMPS_POWER_OUT: C204.1, L201.1, U202.2 (SW)
GND_IO: C202.2, C203.2, C205.2, C206.2, C207.2, C208.2, C209.2, C210.2, C211.2, C212.2, C213.2, C214.2, C215.2, H201.1, H202.1, H203.1, H204.1, J201.2, J202.2 (GND), J203.3 (GND), J204.3 (GND), J205.7 (GND), J205.8 (GND), J205.10 (GND), J205.12 (GND), J205.14 (GND), J205.16 (GND), J205.18 (GND), J205.20 (GND), J206.2 (GND), J207.3 (GND), J208.3 (GND), R203.2, R204.2, R205.2, R206.2, R207.2, U201.1 (GND), U202.3 (GND)
unnamed: C210.1, J202.1 (VCC), L202.2
unnamed: C213.1, J206.1 (VCC), L203.2
unnamed: C204.2, U202.4 (BST)
unnamed: R201.2, U202.5 (EN)

Notes on the sheet:
C41856886
C189267
C404762
C3096082
C337905
C2906661
C7501245
VIN has Vh>2V, so logic level converter is not needed
C77082
IDC Connector
Power Supply: 9-15V -SMPS-> 5V -LDO-> 3V3
ADAT Terminals

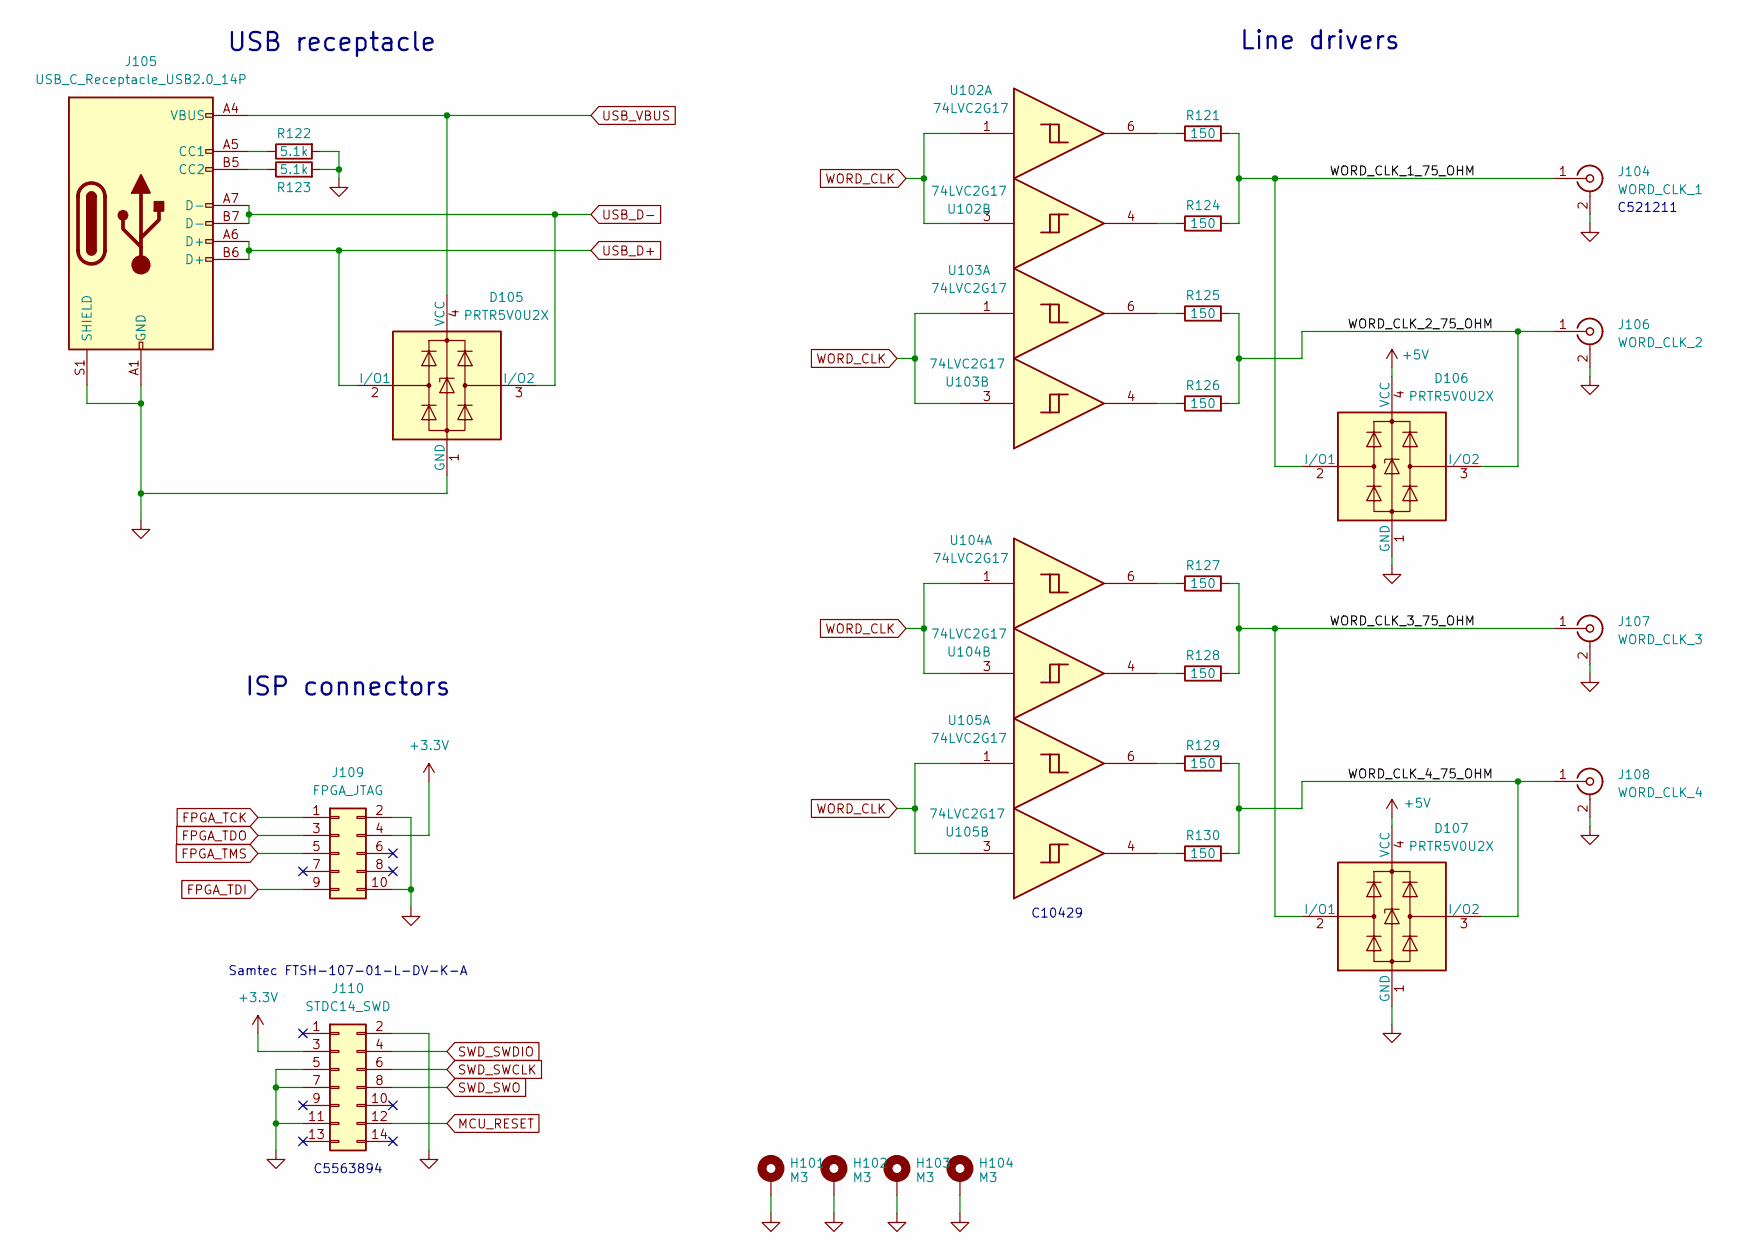
[picture p29: schematic io.kicad_sch, 16-in, 16-out USB <-> ADAT interface]

Parts:
D105, D106, D107: PRTR5V0U2X; SOT-143
H101, H102, H103, H104: M3; MountingHole_3.2mm_M3_Pad
J104: WORD_CLK_1; BNC_dosinconn_DOSIN-801-0051
J105: USB_C_Receptacle_USB2.0_14P; USB_C_Receptacle_GCT_USB4105-xx-A_16P_TopMnt_Horizontal
J106: WORD_CLK_2; BNC_dosinconn_DOSIN-801-0051
J107: WORD_CLK_3; BNC_dosinconn_DOSIN-801-0051
J108: WORD_CLK_4; BNC_dosinconn_DOSIN-801-0051
J109: FPGA_JTAG; IDC-Header_2x05_P2.54mm_Vertical
J110: STDC14_SWD; Samtec-FTSH-107-01-L-DV-K
R121, R124, R125, R126, R127, R128, R129, R130: 150; R_0805_2012Metric_Pad1.20x1.40mm_HandSolder
R122, R123: 5.1k; R_0805_2012Metric_Pad1.20x1.40mm_HandSolder
U102, U103, U104, U105: 74LVC2G17; SOT-23-6_Handsoldering

Connections:
+3.3V: J109.4, J110.3; also elsewhere on the board
+5V: D106.4 (VCC), D107.4 (VCC); also elsewhere on the board
/IO main/WORD_CLK_1_75_OHM: D106.2 (I/O1), J104.1 (In), R121.2, R124.2
/IO main/WORD_CLK_2_75_OHM: D106.3 (I/O2), J106.1 (In), R125.2, R126.2
/IO main/WORD_CLK_3_75_OHM: D107.2 (I/O1), J107.1 (In), R127.2, R128.2
/IO main/WORD_CLK_4_75_OHM: D107.3 (I/O2), J108.1 (In), R129.2, R130.2
FPGA_TCK: J109.1; also elsewhere on the board
FPGA_TDI: J109.9; also elsewhere on the board
FPGA_TDO: J109.3; also elsewhere on the board
FPGA_TMS: J109.5; also elsewhere on the board
GND: D105.1 (GND), D106.1 (GND), D107.1 (GND), H101.1, H102.1, H103.1, H104.1, J104.2 (Ext), J105.A1 (GND), J105.A12 (GND), J105.B1 (GND), J105.B12 (GND), J105.S1 (SHIELD), J106.2 (Ext), J107.2 (Ext), J108.2 (Ext), J109.2, J109.10, J110.2, J110.5, J110.7, J110.11, R122.2, R123.2; also elsewhere on the board
MCU_RESET: J110.12; also elsewhere on the board
unnamed: J105.A5 (CC1), R122.1
unnamed: J105.B5 (CC2), R123.1
unnamed: R121.1, U102.6
unnamed: R124.1, U102.4
unnamed: R125.1, U103.6
unnamed: R126.1, U103.4
unnamed: R127.1, U104.6
unnamed: R128.1, U104.4
unnamed: R129.1, U105.6
unnamed: R130.1, U105.4
SWD_SWCLK: J110.6; also elsewhere on the board
SWD_SWDIO: J110.4; also elsewhere on the board
SWD_SWO: J110.8; also elsewhere on the board
USB_D+: D105.2 (I/O1), J105.A6 (D+), J105.B6 (D+); also elsewhere on the board
USB_D-: D105.3 (I/O2), J105.A7 (D-), J105.B7 (D-); also elsewhere on the board
USB_VBUS: D105.4 (VCC), J105.A4 (VBUS), J105.A9 (VBUS), J105.B4 (VBUS), J105.B9 (VBUS); also elsewhere on the board
WORD_CLK: U102.1, U102.3, U103.1, U103.3, U104.1, U104.3, U105.1, U105.3; also elsewhere on the board

Notes on the sheet:
Line drivers
C10429
C5563894
Samtec FTSH-107-01-L-DV-K-A
USB receptacle
ISP connectors
C521211

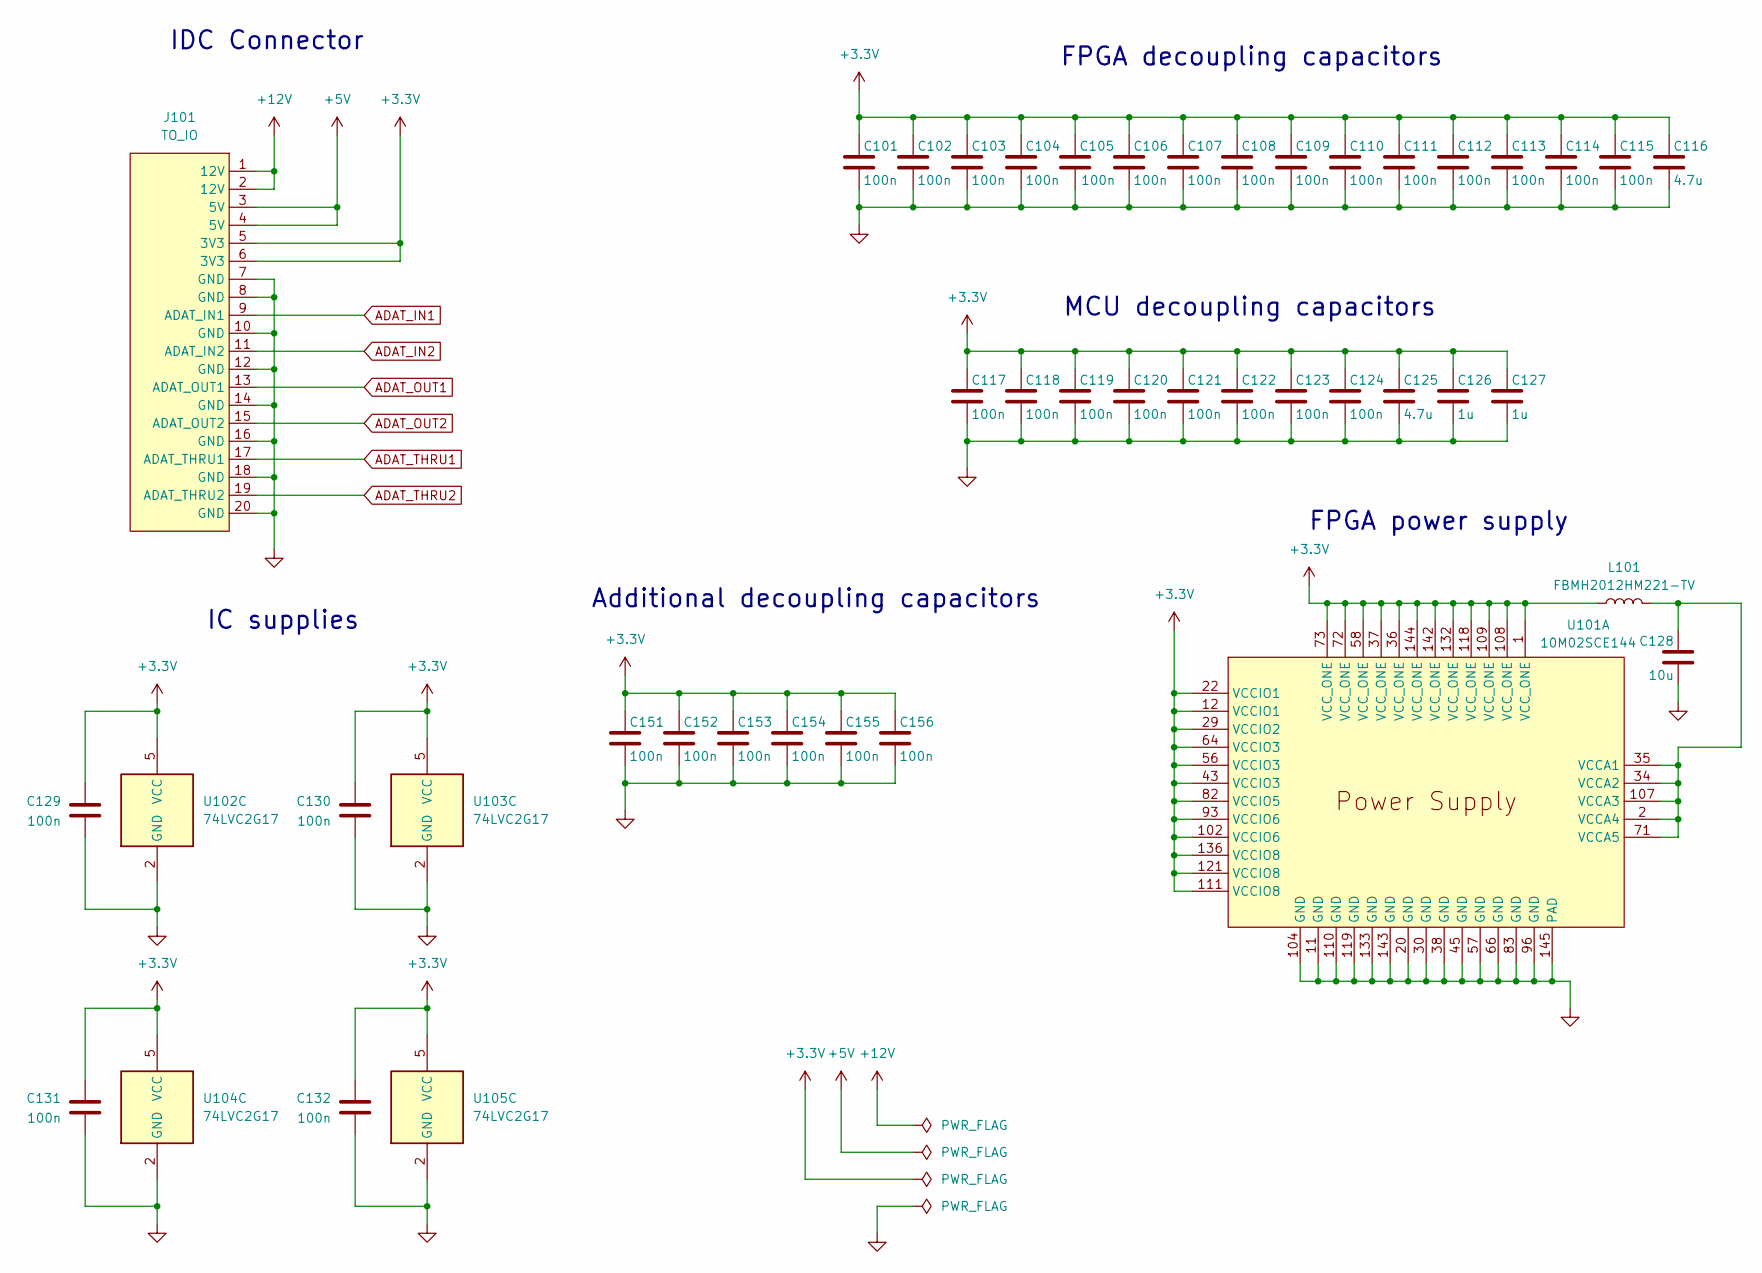
[picture p30: schematic power_supply.kicad_sch, 16-in, 16-out USB <-> ADAT interface]

Parts:
C101, C102, C103, C104, C105, C106, C107, C108, C109, C110, C111, C112, C113, C114, C115, C117, C118, C119, C120, C121, C122, C123, C124, C129, C130, C131, C132, C151, C152, C153, C154, C155, C156: 100n; C_0805_2012Metric_Pad1.18x1.45mm_HandSolder
C116, C125: 4.7u; C_0805_2012Metric_Pad1.18x1.45mm_HandSolder
C126, C127: 1u; C_0805_2012Metric_Pad1.18x1.45mm_HandSolder
C128: 10u; C_1206_3216Metric_Pad1.33x1.80mm_HandSolder
J101: TO_IO; IDC-Header_2x10_P2.54mm_Vertical
L101: FBMH2012HM221-TV; L_0805_2012Metric_Pad1.15x1.40mm_HandSolder
U101: 10M02SCE144; EQFP-144-1EP_20x20mm_P0.5mm_EP4x4mm
U102, U103, U104, U105: 74LVC2G17; SOT-23-6_Handsoldering

Connections:
+3.3V: C101.1, C102.1, C103.1, C104.1, C105.1, C106.1, C107.1, C108.1, C109.1, C110.1, C111.1, C112.1, C113.1, C114.1, C115.1, C116.1, C117.1, C118.1, C119.1, C120.1, C121.1, C122.1, C123.1, C124.1, C125.1, C126.1, C127.1, C129.1, C130.1, C131.1, C132.1, C151.1, C152.1, C153.1, C154.1, C155.1, C156.1, J101.5 (3V3), J101.6 (3V3), L101.1, U101.1 (VCC_ONE), U101.12 (VCCIO1), U101.22 (VCCIO1), U101.29 (VCCIO2), U101.36 (VCC_ONE), U101.37 (VCC_ONE), U101.43 (VCCIO3), U101.56 (VCCIO3), U101.58 (VCC_ONE), U101.64 (VCCIO3), U101.72 (VCC_ONE), U101.73 (VCC_ONE), U101.82 (VCCIO5), U101.93 (VCCIO6), U101.102 (VCCIO6), U101.108 (VCC_ONE), U101.109 (VCC_ONE), U101.111 (VCCIO8), U101.118 (VCC_ONE), U101.121 (VCCIO8), U101.132 (VCC_ONE), U101.136 (VCCIO8), U101.142 (VCC_ONE), U101.144 (VCC_ONE), U102.5 (VCC), U103.5 (VCC), U104.5 (VCC), U105.5 (VCC); also elsewhere on the board
+5V: J101.3 (5V), J101.4 (5V); also elsewhere on the board
+12V: J101.1 (12V), J101.2 (12V)
ADAT_IN1: J101.9 (ADAT_IN1); also elsewhere on the board
ADAT_IN2: J101.11 (ADAT_IN2); also elsewhere on the board
ADAT_OUT1: J101.13 (ADAT_OUT1); also elsewhere on the board
ADAT_OUT2: J101.15 (ADAT_OUT2); also elsewhere on the board
ADAT_THRU1: J101.17 (ADAT_THRU1); also elsewhere on the board
ADAT_THRU2: J101.19 (ADAT_THRU2); also elsewhere on the board
GND: C101.2, C102.2, C103.2, C104.2, C105.2, C106.2, C107.2, C108.2, C109.2, C110.2, C111.2, C112.2, C113.2, C114.2, C115.2, C116.2, C117.2, C118.2, C119.2, C120.2, C121.2, C122.2, C123.2, C124.2, C125.2, C126.2, C127.2, C128.2, C129.2, C130.2, C131.2, C132.2, C151.2, C152.2, C153.2, C154.2, C155.2, C156.2, J101.7 (GND), J101.8 (GND), J101.10 (GND), J101.12 (GND), J101.14 (GND), J101.16 (GND), J101.18 (GND), J101.20 (GND), U101.11 (GND), U101.20 (GND), U101.30 (GND), U101.38 (GND), U101.45 (GND), U101.57 (GND), U101.66 (GND), U101.83 (GND), U101.96 (GND), U101.104 (GND), U101.110 (GND), U101.119 (GND), U101.133 (GND), U101.143 (GND), U101.145 (PAD), U102.2 (GND), U103.2 (GND), U104.2 (GND), U105.2 (GND); also elsewhere on the board
unnamed: C128.1, L101.2, U101.2 (VCCA4), U101.34 (VCCA2), U101.35 (VCCA1), U101.71 (VCCA5), U101.107 (VCCA3)

Notes on the sheet:
IC supplies
IDC Connector
FPGA decoupling capacitors
FPGA power supply
Additional decoupling capacitors
MCU decoupling capacitors
