swiszczoo/adat_usb_interface/pcb/adatv2.kicad_pcb

## KiCad design pcb/adatv2.kicad_pcb (continued)

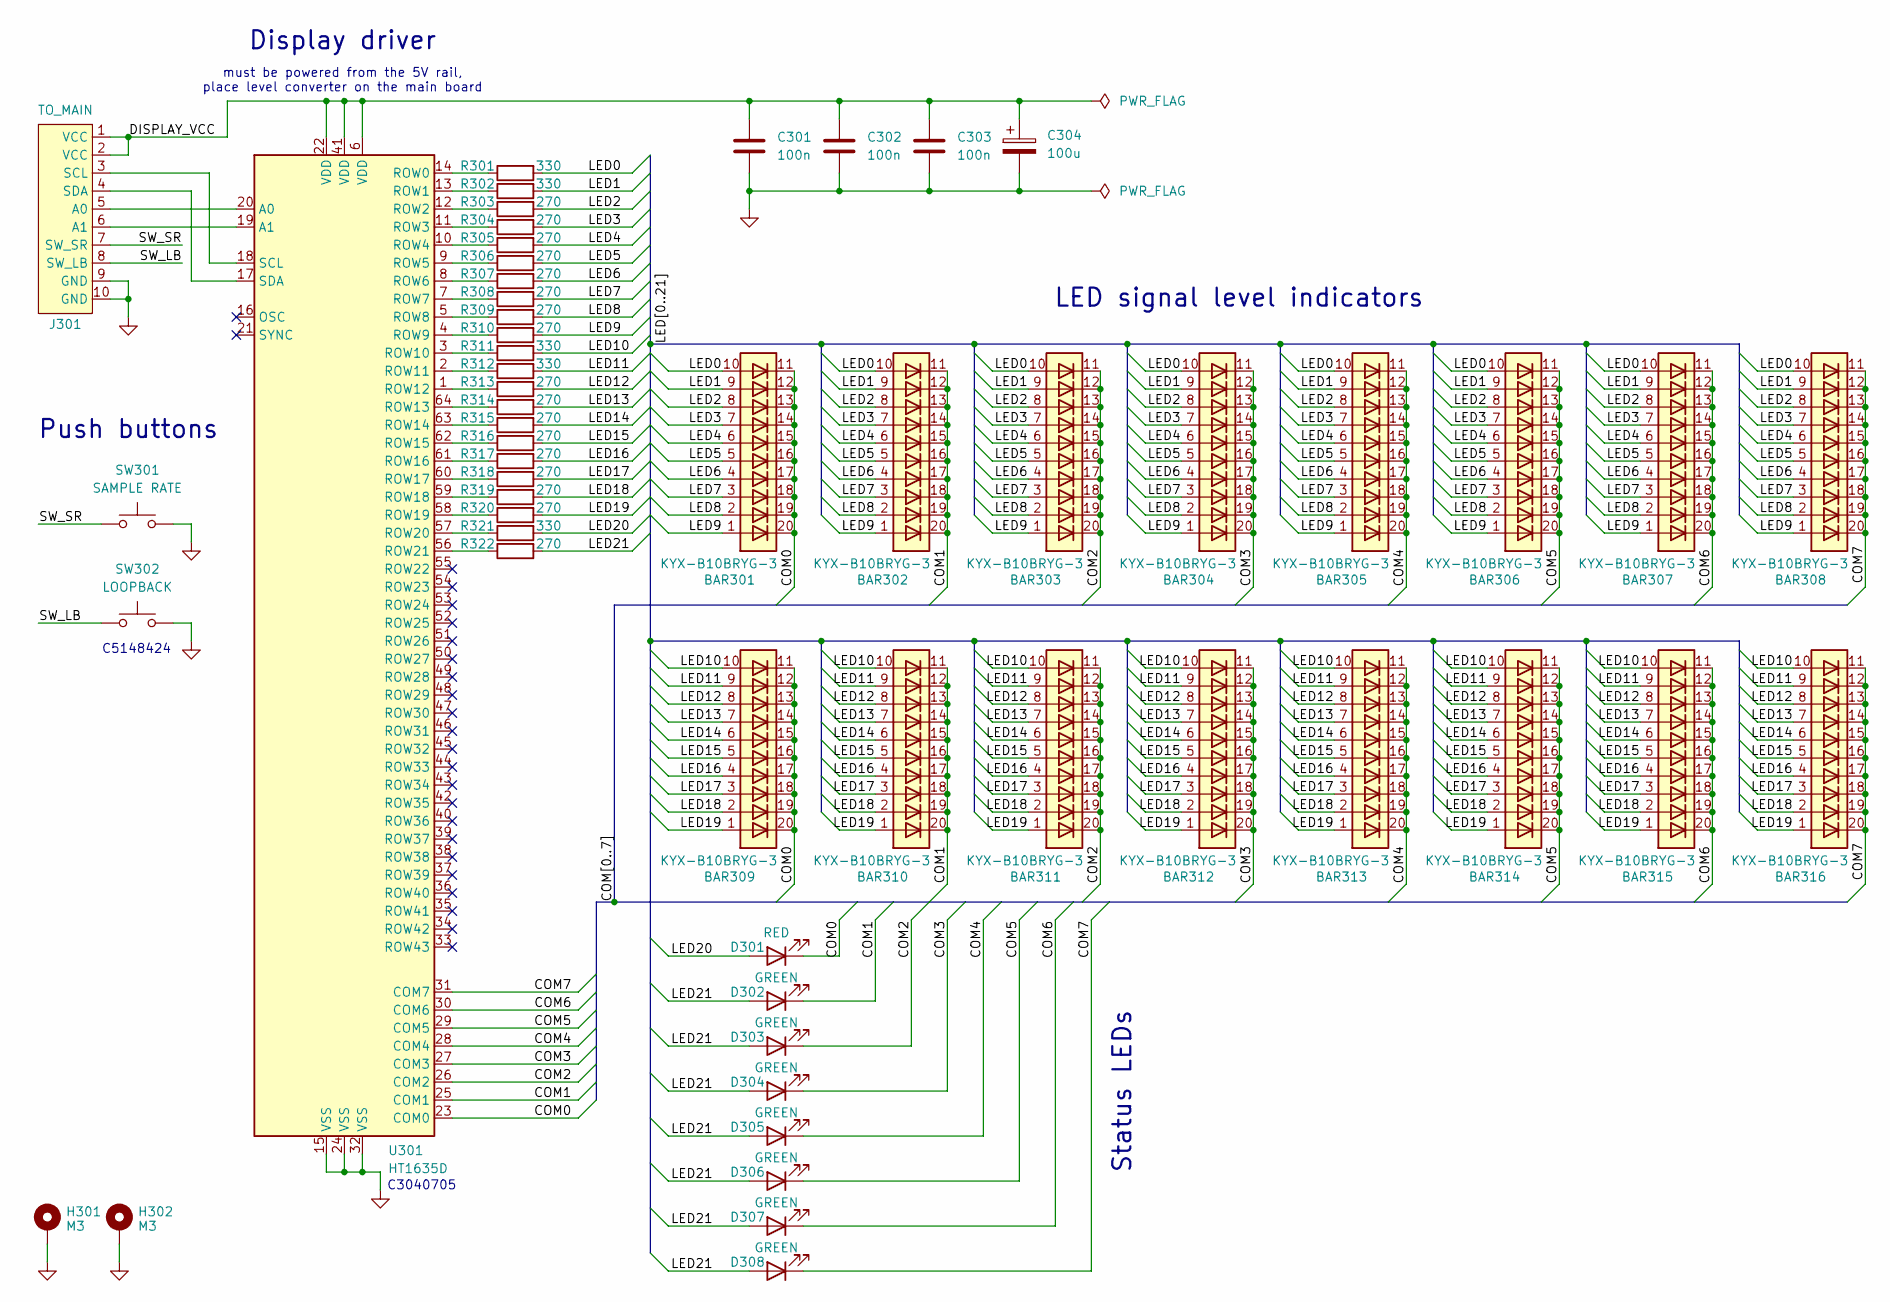
[picture p31: schematic display_board.kicad_sch, 16-in, 16-out USB <-> ADAT interface]

Parts:
BAR301, BAR302, BAR303, BAR304, BAR305, BAR306, BAR307, BAR308, BAR309, BAR310, BAR311, BAR312, BAR313, BAR314, BAR315, BAR316: KYX-B10BRYG-3; LED_10bar
C301, C302, C303: 100n; C_0805_2012Metric_Pad1.18x1.45mm_HandSolder
C304: 100u; C_Elec_6.3x5.4
D301: RED; LED_THT_W7.0mm_H2.00mm
D302, D303, D304, D305, D306, D307, D308: GREEN; LED_THT_W7.0mm_H2.00mm
H301, H302: M3; MountingHole_3.2mm_M3_Pad
J301: TO_MAIN; IDC-Header_2x05_P2.54mm_Vertical
R301, R302, R311, R312, R321: 330; R_0805_2012Metric_Pad1.20x1.40mm_HandSolder
R303, R304, R305, R306, R307, R308, R309, R310, R313, R314, R315, R316, R317, R318, R319, R320, R322: 270; R_0805_2012Metric_Pad1.20x1.40mm_HandSolder
SW301: SAMPLE RATE; SW_Push_1P1T_NO_CK_PTS125Sx43SMTR
SW302: LOOPBACK; SW_Push_1P1T_NO_CK_PTS125Sx43SMTR
U301: HT1635D; LQFP-64_7x7mm_P0.4mm

Connections:
/Display board/COM0: BAR301.11 (K), BAR301.12 (K), BAR301.13 (K), BAR301.14 (K), BAR301.15 (K), BAR301.16 (K), BAR301.17 (K), BAR301.18 (K), BAR301.19 (K), BAR301.20 (K), BAR309.11 (K), BAR309.12 (K), BAR309.13 (K), BAR309.14 (K), BAR309.15 (K), BAR309.16 (K), BAR309.17 (K), BAR309.18 (K), BAR309.19 (K), BAR309.20 (K), D301.1 (K), U301.23 (COM0)
/Display board/COM1: BAR302.11 (K), BAR302.12 (K), BAR302.13 (K), BAR302.14 (K), BAR302.15 (K), BAR302.16 (K), BAR302.17 (K), BAR302.18 (K), BAR302.19 (K), BAR302.20 (K), BAR310.11 (K), BAR310.12 (K), BAR310.13 (K), BAR310.14 (K), BAR310.15 (K), BAR310.16 (K), BAR310.17 (K), BAR310.18 (K), BAR310.19 (K), BAR310.20 (K), D302.1 (K), U301.25 (COM1)
/Display board/COM2: BAR303.11 (K), BAR303.12 (K), BAR303.13 (K), BAR303.14 (K), BAR303.15 (K), BAR303.16 (K), BAR303.17 (K), BAR303.18 (K), BAR303.19 (K), BAR303.20 (K), BAR311.11 (K), BAR311.12 (K), BAR311.13 (K), BAR311.14 (K), BAR311.15 (K), BAR311.16 (K), BAR311.17 (K), BAR311.18 (K), BAR311.19 (K), BAR311.20 (K), D303.1 (K), U301.26 (COM2)
/Display board/COM3: BAR304.11 (K), BAR304.12 (K), BAR304.13 (K), BAR304.14 (K), BAR304.15 (K), BAR304.16 (K), BAR304.17 (K), BAR304.18 (K), BAR304.19 (K), BAR304.20 (K), BAR312.11 (K), BAR312.12 (K), BAR312.13 (K), BAR312.14 (K), BAR312.15 (K), BAR312.16 (K), BAR312.17 (K), BAR312.18 (K), BAR312.19 (K), BAR312.20 (K), D304.1 (K), U301.27 (COM3)
/Display board/COM4: BAR305.11 (K), BAR305.12 (K), BAR305.13 (K), BAR305.14 (K), BAR305.15 (K), BAR305.16 (K), BAR305.17 (K), BAR305.18 (K), BAR305.19 (K), BAR305.20 (K), BAR313.11 (K), BAR313.12 (K), BAR313.13 (K), BAR313.14 (K), BAR313.15 (K), BAR313.16 (K), BAR313.17 (K), BAR313.18 (K), BAR313.19 (K), BAR313.20 (K), D305.1 (K), U301.28 (COM4)
/Display board/COM5: BAR306.11 (K), BAR306.12 (K), BAR306.13 (K), BAR306.14 (K), BAR306.15 (K), BAR306.16 (K), BAR306.17 (K), BAR306.18 (K), BAR306.19 (K), BAR306.20 (K), BAR314.11 (K), BAR314.12 (K), BAR314.13 (K), BAR314.14 (K), BAR314.15 (K), BAR314.16 (K), BAR314.17 (K), BAR314.18 (K), BAR314.19 (K), BAR314.20 (K), D306.1 (K), U301.29 (COM5)
/Display board/COM6: BAR307.11 (K), BAR307.12 (K), BAR307.13 (K), BAR307.14 (K), BAR307.15 (K), BAR307.16 (K), BAR307.17 (K), BAR307.18 (K), BAR307.19 (K), BAR307.20 (K), BAR315.11 (K), BAR315.12 (K), BAR315.13 (K), BAR315.14 (K), BAR315.15 (K), BAR315.16 (K), BAR315.17 (K), BAR315.18 (K), BAR315.19 (K), BAR315.20 (K), D307.1 (K), U301.30 (COM6)
/Display board/COM7: BAR308.11 (K), BAR308.12 (K), BAR308.13 (K), BAR308.14 (K), BAR308.15 (K), BAR308.16 (K), BAR308.17 (K), BAR308.18 (K), BAR308.19 (K), BAR308.20 (K), BAR316.11 (K), BAR316.12 (K), BAR316.13 (K), BAR316.14 (K), BAR316.15 (K), BAR316.16 (K), BAR316.17 (K), BAR316.18 (K), BAR316.19 (K), BAR316.20 (K), D308.1 (K), U301.31 (COM7)
/Display board/DISPLAY_VCC: C301.1, C302.1, C303.1, C304.1, J301.1 (VCC), J301.2 (VCC), U301.6 (VDD), U301.22 (VDD), U301.41 (VDD)
/Display board/LED0: BAR301.10 (A), BAR302.10 (A), BAR303.10 (A), BAR304.10 (A), BAR305.10 (A), BAR306.10 (A), BAR307.10 (A), BAR308.10 (A), R301.2
/Display board/LED1: BAR301.9 (A), BAR302.9 (A), BAR303.9 (A), BAR304.9 (A), BAR305.9 (A), BAR306.9 (A), BAR307.9 (A), BAR308.9 (A), R302.2
/Display board/LED2: BAR301.8 (A), BAR302.8 (A), BAR303.8 (A), BAR304.8 (A), BAR305.8 (A), BAR306.8 (A), BAR307.8 (A), BAR308.8 (A), R303.2
/Display board/LED3: BAR301.7 (A), BAR302.7 (A), BAR303.7 (A), BAR304.7 (A), BAR305.7 (A), BAR306.7 (A), BAR307.7 (A), BAR308.7 (A), R304.2
/Display board/LED4: BAR301.6 (A), BAR302.6 (A), BAR303.6 (A), BAR304.6 (A), BAR305.6 (A), BAR306.6 (A), BAR307.6 (A), BAR308.6 (A), R305.2
/Display board/LED5: BAR301.5 (A), BAR302.5 (A), BAR303.5 (A), BAR304.5 (A), BAR305.5 (A), BAR306.5 (A), BAR307.5 (A), BAR308.5 (A), R306.2
/Display board/LED6: BAR301.4 (A), BAR302.4 (A), BAR303.4 (A), BAR304.4 (A), BAR305.4 (A), BAR306.4 (A), BAR307.4 (A), BAR308.4 (A), R307.2
/Display board/LED7: BAR301.3 (A), BAR302.3 (A), BAR303.3 (A), BAR304.3 (A), BAR305.3 (A), BAR306.3 (A), BAR307.3 (A), BAR308.3 (A), R308.2
/Display board/LED8: BAR301.2 (A), BAR302.2 (A), BAR303.2 (A), BAR304.2 (A), BAR305.2 (A), BAR306.2 (A), BAR307.2 (A), BAR308.2 (A), R309.2
/Display board/LED9: BAR301.1 (A), BAR302.1 (A), BAR303.1 (A), BAR304.1 (A), BAR305.1 (A), BAR306.1 (A), BAR307.1 (A), BAR308.1 (A), R310.2
/Display board/LED10: BAR309.10 (A), BAR310.10 (A), BAR311.10 (A), BAR312.10 (A), BAR313.10 (A), BAR314.10 (A), BAR315.10 (A), BAR316.10 (A), R311.2
/Display board/LED11: BAR309.9 (A), BAR310.9 (A), BAR311.9 (A), BAR312.9 (A), BAR313.9 (A), BAR314.9 (A), BAR315.9 (A), BAR316.9 (A), R312.2
/Display board/LED12: BAR309.8 (A), BAR310.8 (A), BAR311.8 (A), BAR312.8 (A), BAR313.8 (A), BAR314.8 (A), BAR315.8 (A), BAR316.8 (A), R313.2
/Display board/LED13: BAR309.7 (A), BAR310.7 (A), BAR311.7 (A), BAR312.7 (A), BAR313.7 (A), BAR314.7 (A), BAR315.7 (A), BAR316.7 (A), R314.2
/Display board/LED14: BAR309.6 (A), BAR310.6 (A), BAR311.6 (A), BAR312.6 (A), BAR313.6 (A), BAR314.6 (A), BAR315.6 (A), BAR316.6 (A), R315.2
/Display board/LED15: BAR309.5 (A), BAR310.5 (A), BAR311.5 (A), BAR312.5 (A), BAR313.5 (A), BAR314.5 (A), BAR315.5 (A), BAR316.5 (A), R316.2
/Display board/LED16: BAR309.4 (A), BAR310.4 (A), BAR311.4 (A), BAR312.4 (A), BAR313.4 (A), BAR314.4 (A), BAR315.4 (A), BAR316.4 (A), R317.2
/Display board/LED17: BAR309.3 (A), BAR310.3 (A), BAR311.3 (A), BAR312.3 (A), BAR313.3 (A), BAR314.3 (A), BAR315.3 (A), BAR316.3 (A), R318.2
/Display board/LED18: BAR309.2 (A), BAR310.2 (A), BAR311.2 (A), BAR312.2 (A), BAR313.2 (A), BAR314.2 (A), BAR315.2 (A), BAR316.2 (A), R319.2
/Display board/LED19: BAR309.1 (A), BAR310.1 (A), BAR311.1 (A), BAR312.1 (A), BAR313.1 (A), BAR314.1 (A), BAR315.1 (A), BAR316.1 (A), R320.2
/Display board/LED20: D301.2 (A), R321.2
/Display board/LED21: D302.2 (A), D303.2 (A), D304.2 (A), D305.2 (A), D306.2 (A), D307.2 (A), D308.2 (A), R322.2
/Display board/SW_LB: J301.8 (SW_LB), SW302.1
/Display board/SW_SR: J301.7 (SW_SR), SW301.1
DISPLAY_GND: C301.2, C302.2, C303.2, C304.2, H301.1, H302.1, J301.9 (GND), J301.10 (GND), SW301.2, SW302.2, U301.15 (VSS), U301.24 (VSS), U301.32 (VSS)
unnamed: J301.5 (A0), U301.20 (A0)
unnamed: J301.6 (A1), U301.19 (A1)
unnamed: J301.3 (SCL), U301.18 (SCL)
unnamed: J301.4 (SDA), U301.17 (SDA)
unnamed: R301.1, U301.14 (ROW0)
unnamed: R302.1, U301.13 (ROW1)
unnamed: R303.1, U301.12 (ROW2)
unnamed: R304.1, U301.11 (ROW3)
unnamed: R305.1, U301.10 (ROW4)
unnamed: R306.1, U301.9 (ROW5)
unnamed: R307.1, U301.8 (ROW6)
unnamed: R308.1, U301.7 (ROW7)
unnamed: R309.1, U301.5 (ROW8)
unnamed: R310.1, U301.4 (ROW9)
unnamed: R311.1, U301.3 (ROW10)
unnamed: R312.1, U301.2 (ROW11)
unnamed: R313.1, U301.1 (ROW12)
unnamed: R314.1, U301.64 (ROW13)
unnamed: R315.1, U301.63 (ROW14)
unnamed: R316.1, U301.62 (ROW15)
unnamed: R317.1, U301.61 (ROW16)
unnamed: R318.1, U301.60 (ROW17)
unnamed: R319.1, U301.59 (ROW18)
unnamed: R320.1, U301.58 (ROW19)
unnamed: R321.1, U301.57 (ROW20)
unnamed: R322.1, U301.56 (ROW21)

Notes on the sheet:
C3040705
Status LEDs
Display driver
LED signal level indicators
C5148424
must be powered from the 5V rail, place level converter on the main board
Push buttons

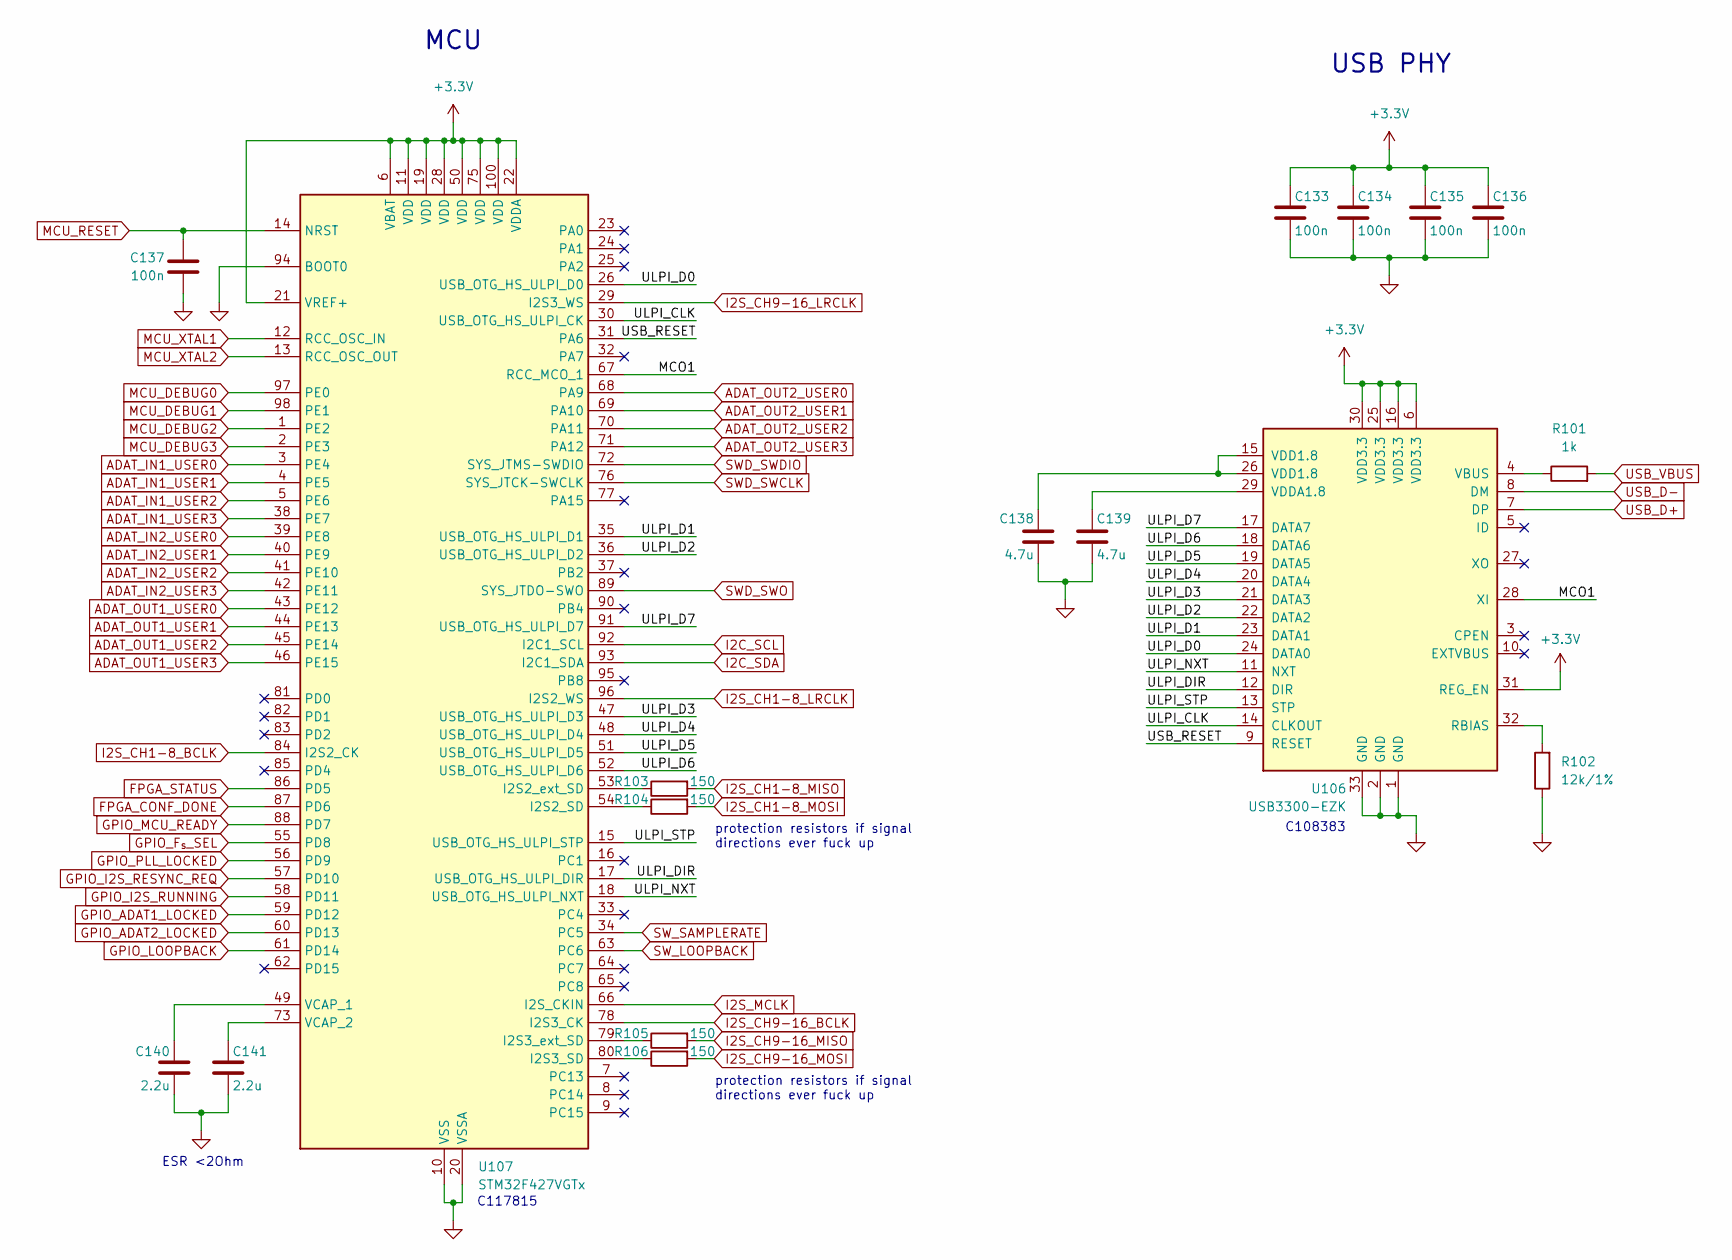
[picture p32: schematic main_board.kicad_sch, 16-in, 16-out USB <-> ADAT interface]

Parts:
C133, C134, C135, C136, C137: 100n; C_0805_2012Metric_Pad1.18x1.45mm_HandSolder
C138, C139: 4.7u; C_0805_2012Metric_Pad1.18x1.45mm_HandSolder
C140, C141: 2.2u; C_0805_2012Metric_Pad1.18x1.45mm_HandSolder
R101: 1k; R_0805_2012Metric_Pad1.20x1.40mm_HandSolder
R102: 12k/1%; R_0805_2012Metric_Pad1.20x1.40mm_HandSolder
R103, R104, R105, R106: 150; R_0805_2012Metric_Pad1.20x1.40mm_HandSolder
U106: USB3300-EZK; QFN-32-1EP_5x5mm_P0.5mm_EP3.45x3.45mm
U107: STM32F427VGTx; LQFP-100_14x14mm_P0.5mm

Connections:
+3.3V: C133.1, C134.1, C135.1, C136.1, U106.6 (VDD3.3), U106.16 (VDD3.3), U106.25 (VDD3.3), U106.30 (VDD3.3), U106.31 (REG_EN), U107.6 (VBAT), U107.11 (VDD), U107.19 (VDD), U107.21 (VREF+), U107.22 (VDDA), U107.28 (VDD), U107.50 (VDD), U107.75 (VDD), U107.100 (VDD); also elsewhere on the board
/MCU and USB/MCO1: U106.28 (XI), U107.67 (RCC_MCO_1)
/MCU and USB/ULPI_CLK: U106.14 (CLKOUT), U107.30 (USB_OTG_HS_ULPI_CK)
/MCU and USB/ULPI_D0: U106.24 (DATA0), U107.26 (USB_OTG_HS_ULPI_D0)
/MCU and USB/ULPI_D1: U106.23 (DATA1), U107.35 (USB_OTG_HS_ULPI_D1)
/MCU and USB/ULPI_D2: U106.22 (DATA2), U107.36 (USB_OTG_HS_ULPI_D2)
/MCU and USB/ULPI_D3: U106.21 (DATA3), U107.47 (USB_OTG_HS_ULPI_D3)
/MCU and USB/ULPI_D4: U106.20 (DATA4), U107.48 (USB_OTG_HS_ULPI_D4)
/MCU and USB/ULPI_D5: U106.19 (DATA5), U107.51 (USB_OTG_HS_ULPI_D5)
/MCU and USB/ULPI_D6: U106.18 (DATA6), U107.52 (USB_OTG_HS_ULPI_D6)
/MCU and USB/ULPI_D7: U106.17 (DATA7), U107.91 (USB_OTG_HS_ULPI_D7)
/MCU and USB/ULPI_DIR: U106.12 (DIR), U107.17 (USB_OTG_HS_ULPI_DIR)
/MCU and USB/ULPI_NXT: U106.11 (NXT), U107.18 (USB_OTG_HS_ULPI_NXT)
/MCU and USB/ULPI_STP: U106.13 (STP), U107.15 (USB_OTG_HS_ULPI_STP)
/MCU and USB/USB_RESET: U106.9 (RESET), U107.31 (PA6)
ADAT_IN1_USER0: U107.3 (PE4); also elsewhere on the board
ADAT_IN1_USER1: U107.4 (PE5); also elsewhere on the board
ADAT_IN1_USER2: U107.5 (PE6); also elsewhere on the board
ADAT_IN1_USER3: U107.38 (PE7); also elsewhere on the board
ADAT_IN2_USER0: U107.39 (PE8); also elsewhere on the board
ADAT_IN2_USER1: U107.40 (PE9); also elsewhere on the board
ADAT_IN2_USER2: U107.41 (PE10); also elsewhere on the board
ADAT_IN2_USER3: U107.42 (PE11); also elsewhere on the board
ADAT_OUT1_USER0: U107.43 (PE12); also elsewhere on the board
ADAT_OUT1_USER1: U107.44 (PE13); also elsewhere on the board
ADAT_OUT1_USER2: U107.45 (PE14); also elsewhere on the board
ADAT_OUT1_USER3: U107.46 (PE15); also elsewhere on the board
ADAT_OUT2_USER0: U107.68 (PA9); also elsewhere on the board
ADAT_OUT2_USER1: U107.69 (PA10); also elsewhere on the board
ADAT_OUT2_USER2: U107.70 (PA11); also elsewhere on the board
ADAT_OUT2_USER3: U107.71 (PA12); also elsewhere on the board
FPGA_CONF_DONE: U107.87 (PD6); also elsewhere on the board
FPGA_STATUS: U107.86 (PD5); also elsewhere on the board
GND: C133.2, C134.2, C135.2, C136.2, C137.2, C138.2, C139.2, C140.2, C141.2, R102.1, U106.1 (GND), U106.2 (GND), U106.33 (GND), U107.10 (VSS), U107.20 (VSSA), U107.27 (VSS), U107.74 (VSS), U107.94 (BOOT0), U107.99 (VSS); also elsewhere on the board
GPIO_ADAT1_LOCKED: U107.59 (PD12); also elsewhere on the board
GPIO_ADAT2_LOCKED: U107.60 (PD13); also elsewhere on the board
GPIO_F_{s}_SEL: U107.55 (PD8); also elsewhere on the board
GPIO_I2S_RESYNC_REQ: U107.57 (PD10); also elsewhere on the board
GPIO_I2S_RUNNING: U107.58 (PD11); also elsewhere on the board
GPIO_LOOPBACK: U107.61 (PD14); also elsewhere on the board
GPIO_MCU_READY: U107.88 (PD7); also elsewhere on the board
GPIO_PLL_LOCKED: U107.56 (PD9); also elsewhere on the board
I2C_SCL: U107.92 (I2C1_SCL); also elsewhere on the board
I2C_SDA: U107.93 (I2C1_SDA); also elsewhere on the board
I2S_CH1-8_BCLK: U107.84 (I2S2_CK); also elsewhere on the board
I2S_CH1-8_LRCLK: U107.96 (I2S2_WS); also elsewhere on the board
I2S_CH1-8_MISO: R103.2; also elsewhere on the board
I2S_CH1-8_MOSI: R104.2; also elsewhere on the board
I2S_CH9-16_BCLK: U107.78 (I2S3_CK); also elsewhere on the board
I2S_CH9-16_LRCLK: U107.29 (I2S3_WS); also elsewhere on the board
I2S_CH9-16_MISO: R105.2; also elsewhere on the board
I2S_CH9-16_MOSI: R106.2; also elsewhere on the board
I2S_MCLK: U107.66 (I2S_CKIN); also elsewhere on the board
MCU_DEBUG0: U107.97 (PE0); also elsewhere on the board
MCU_DEBUG1: U107.98 (PE1); also elsewhere on the board
MCU_DEBUG2: U107.1 (PE2); also elsewhere on the board
MCU_DEBUG3: U107.2 (PE3); also elsewhere on the board
MCU_RESET: C137.1, U107.14 (NRST); also elsewhere on the board
MCU_XTAL1: U107.12 (RCC_OSC_IN); also elsewhere on the board
MCU_XTAL2: U107.13 (RCC_OSC_OUT); also elsewhere on the board
unnamed: C138.1, U106.15 (VDD1.8), U106.26 (VDD1.8)
unnamed: R102.2, U106.32 (RBIAS)
unnamed: R101.1, U106.4 (VBUS)
unnamed: C139.1, U106.29 (VDDA1.8)
unnamed: R103.1, U107.53 (I2S2_ext_SD)
unnamed: R104.1, U107.54 (I2S2_SD)
unnamed: R105.1, U107.79 (I2S3_ext_SD)
unnamed: R106.1, U107.80 (I2S3_SD)
unnamed: C140.1, U107.49 (VCAP_1)
unnamed: C141.1, U107.73 (VCAP_2)
SWD_SWCLK: U107.76 (SYS_JTCK-SWCLK); also elsewhere on the board
SWD_SWDIO: U107.72 (SYS_JTMS-SWDIO); also elsewhere on the board
SWD_SWO: U107.89 (SYS_JTDO-SWO); also elsewhere on the board
SW_LOOPBACK: U107.63 (PC6); also elsewhere on the board
SW_SAMPLERATE: U107.34 (PC5); also elsewhere on the board
USB_D+: U106.7 (DP); also elsewhere on the board
USB_D-: U106.8 (DM); also elsewhere on the board
USB_VBUS: R101.2; also elsewhere on the board

Notes on the sheet:
USB PHY
C108383
MCU
protection resistors if signal directions ever fuck up
C117815
ESR <2Ohm

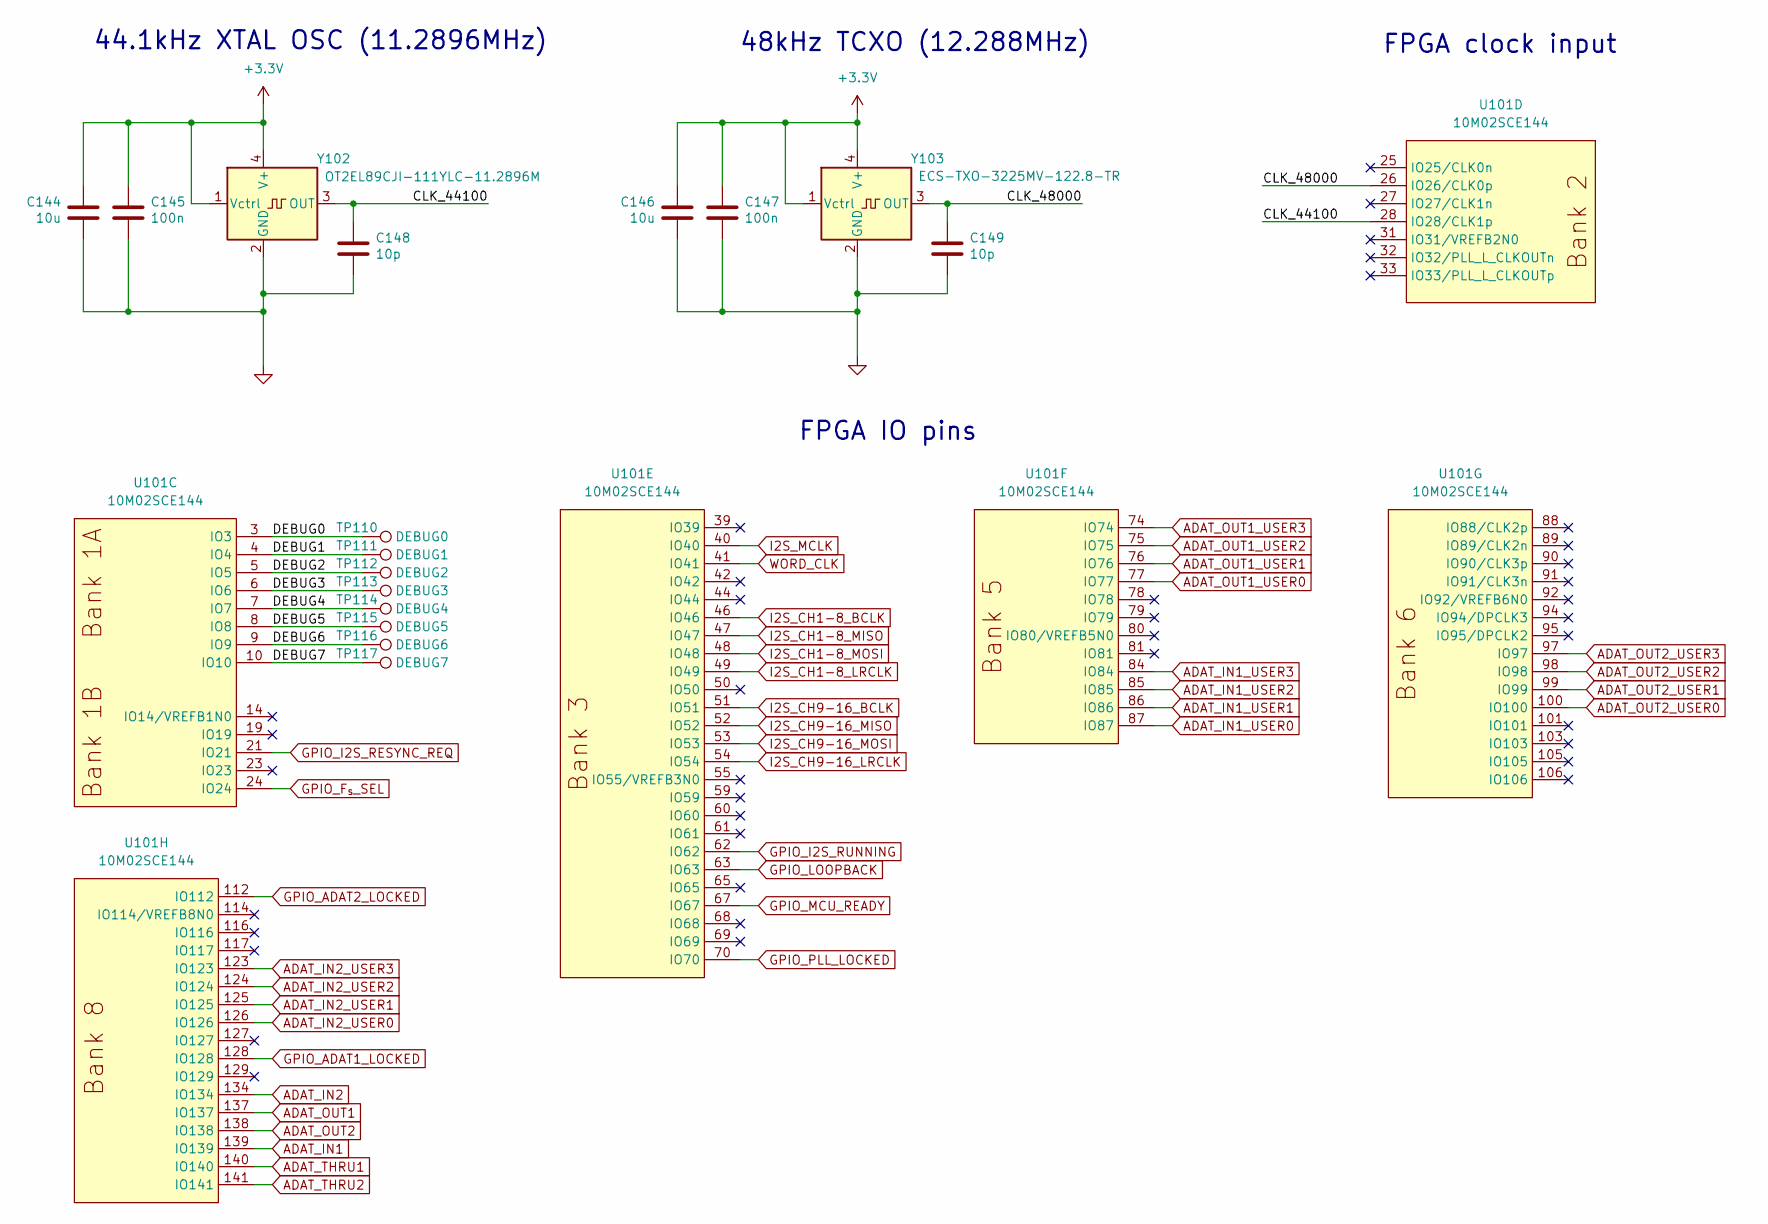
[picture p33: schematic fpga.kicad_sch, 16-in, 16-out USB <-> ADAT interface]

Parts:
C144, C146: 10u; C_1206_3216Metric_Pad1.33x1.80mm_HandSolder
C145, C147: 100n; C_0805_2012Metric_Pad1.18x1.45mm_HandSolder
C148, C149: 10p; C_0805_2012Metric_Pad1.18x1.45mm_HandSolder
TP110: DEBUG0; TestPoint_Pad_D2.5mm
TP111: DEBUG1; TestPoint_Pad_D2.5mm
TP112: DEBUG2; TestPoint_Pad_D2.5mm
TP113: DEBUG3; TestPoint_Pad_D2.5mm
TP114: DEBUG4; TestPoint_Pad_D2.5mm
TP115: DEBUG5; TestPoint_Pad_D2.5mm
TP116: DEBUG6; TestPoint_Pad_D2.5mm
TP117: DEBUG7; TestPoint_Pad_D2.5mm
U101: 10M02SCE144; EQFP-144-1EP_20x20mm_P0.5mm_EP4x4mm
Y102: OT2EL89CJI-111YLC-11.2896M; Oscillator_SMD_Abracon_ASE-4Pin_3.2x2.5mm_HandSoldering
Y103: ECS-TXO-3225MV-122.8-TR; Oscillator_SMD_Abracon_ASE-4Pin_3.2x2.5mm_HandSoldering

Connections:
+3.3V: C144.1, C145.1, C146.1, C147.1, Y102.1 (Vctrl), Y102.4 (V+), Y103.1 (Vctrl), Y103.4 (V+); also elsewhere on the board
/FPGA and clock generators/CLK_44100: C148.1, U101.28 (IO28/CLK1p), Y102.3 (OUT)
/FPGA and clock generators/CLK_48000: C149.1, U101.26 (IO26/CLK0p), Y103.3 (OUT)
/FPGA and clock generators/DEBUG0: TP110.1, U101.3 (IO3)
/FPGA and clock generators/DEBUG1: TP111.1, U101.4 (IO4)
/FPGA and clock generators/DEBUG2: TP112.1, U101.5 (IO5)
/FPGA and clock generators/DEBUG3: TP113.1, U101.6 (IO6)
/FPGA and clock generators/DEBUG4: TP114.1, U101.7 (IO7)
/FPGA and clock generators/DEBUG5: TP115.1, U101.8 (IO8)
/FPGA and clock generators/DEBUG6: TP116.1, U101.9 (IO9)
/FPGA and clock generators/DEBUG7: TP117.1, U101.10 (IO10)
ADAT_IN1: U101.139 (IO139); also elsewhere on the board
ADAT_IN1_USER0: U101.87 (IO87); also elsewhere on the board
ADAT_IN1_USER1: U101.86 (IO86); also elsewhere on the board
ADAT_IN1_USER2: U101.85 (IO85); also elsewhere on the board
ADAT_IN1_USER3: U101.84 (IO84); also elsewhere on the board
ADAT_IN2: U101.134 (IO134); also elsewhere on the board
ADAT_IN2_USER0: U101.126 (IO126); also elsewhere on the board
ADAT_IN2_USER1: U101.125 (IO125); also elsewhere on the board
ADAT_IN2_USER2: U101.124 (IO124); also elsewhere on the board
ADAT_IN2_USER3: U101.123 (IO123); also elsewhere on the board
ADAT_OUT1: U101.137 (IO137); also elsewhere on the board
ADAT_OUT1_USER0: U101.77 (IO77); also elsewhere on the board
ADAT_OUT1_USER1: U101.76 (IO76); also elsewhere on the board
ADAT_OUT1_USER2: U101.75 (IO75); also elsewhere on the board
ADAT_OUT1_USER3: U101.74 (IO74); also elsewhere on the board
ADAT_OUT2: U101.138 (IO138); also elsewhere on the board
ADAT_OUT2_USER0: U101.100 (IO100); also elsewhere on the board
ADAT_OUT2_USER1: U101.99 (IO99); also elsewhere on the board
ADAT_OUT2_USER2: U101.98 (IO98); also elsewhere on the board
ADAT_OUT2_USER3: U101.97 (IO97); also elsewhere on the board
ADAT_THRU1: U101.140 (IO140); also elsewhere on the board
ADAT_THRU2: U101.141 (IO141); also elsewhere on the board
GND: C144.2, C145.2, C146.2, C147.2, C148.2, C149.2, Y102.2 (GND), Y103.2 (GND); also elsewhere on the board
GPIO_ADAT1_LOCKED: U101.128 (IO128); also elsewhere on the board
GPIO_ADAT2_LOCKED: U101.112 (IO112); also elsewhere on the board
GPIO_F_{s}_SEL: U101.24 (IO24); also elsewhere on the board
GPIO_I2S_RESYNC_REQ: U101.21 (IO21); also elsewhere on the board
GPIO_I2S_RUNNING: U101.62 (IO62); also elsewhere on the board
GPIO_LOOPBACK: U101.63 (IO63); also elsewhere on the board
GPIO_MCU_READY: U101.67 (IO67); also elsewhere on the board
GPIO_PLL_LOCKED: U101.70 (IO70); also elsewhere on the board
I2S_CH1-8_BCLK: U101.46 (IO46); also elsewhere on the board
I2S_CH1-8_LRCLK: U101.49 (IO49); also elsewhere on the board
I2S_CH1-8_MISO: U101.47 (IO47); also elsewhere on the board
I2S_CH1-8_MOSI: U101.48 (IO48); also elsewhere on the board
I2S_CH9-16_BCLK: U101.51 (IO51); also elsewhere on the board
I2S_CH9-16_LRCLK: U101.54 (IO54); also elsewhere on the board
I2S_CH9-16_MISO: U101.52 (IO52); also elsewhere on the board
I2S_CH9-16_MOSI: U101.53 (IO53); also elsewhere on the board
I2S_MCLK: U101.40 (IO40); also elsewhere on the board
WORD_CLK: U101.41 (IO41); also elsewhere on the board

Notes on the sheet:
48kHz TCXO (12.288MHz)
44.1kHz XTAL OSC (11.2896MHz)
FPGA IO pins
FPGA clock input

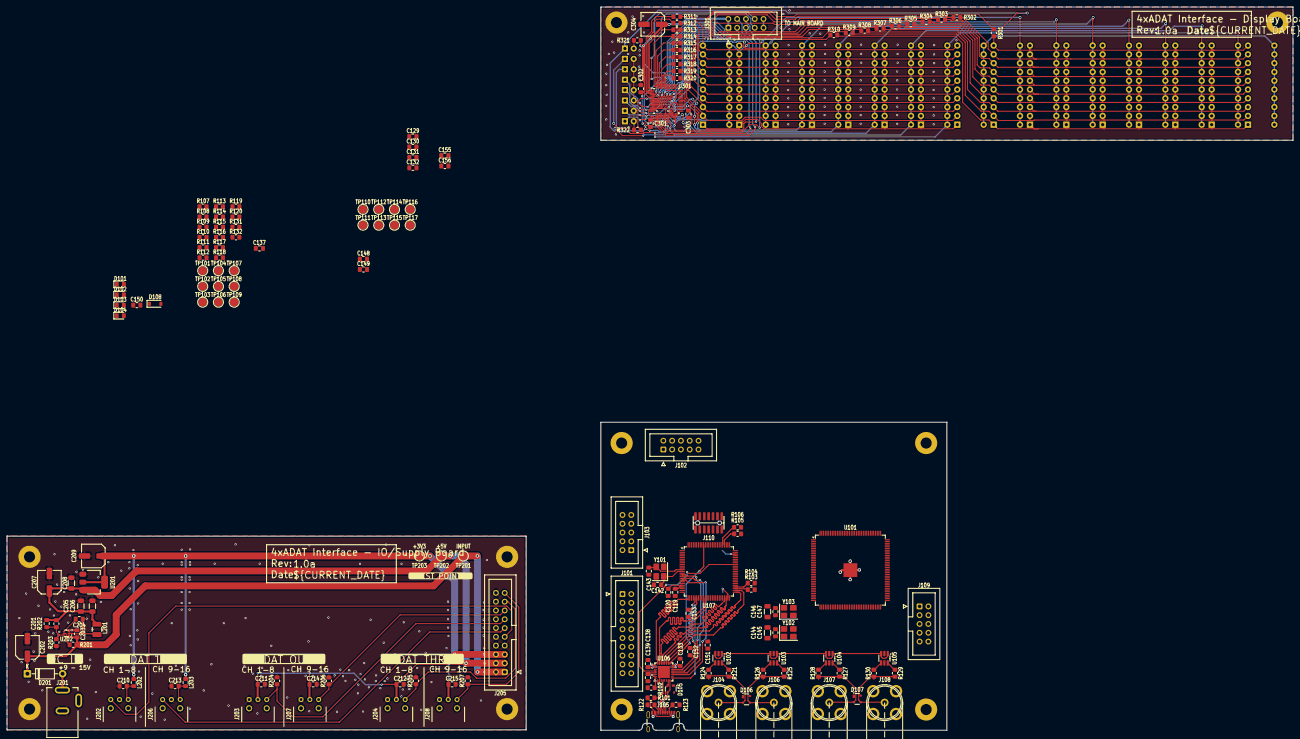
[picture p34: board adatv2.kicad_pcb from above]

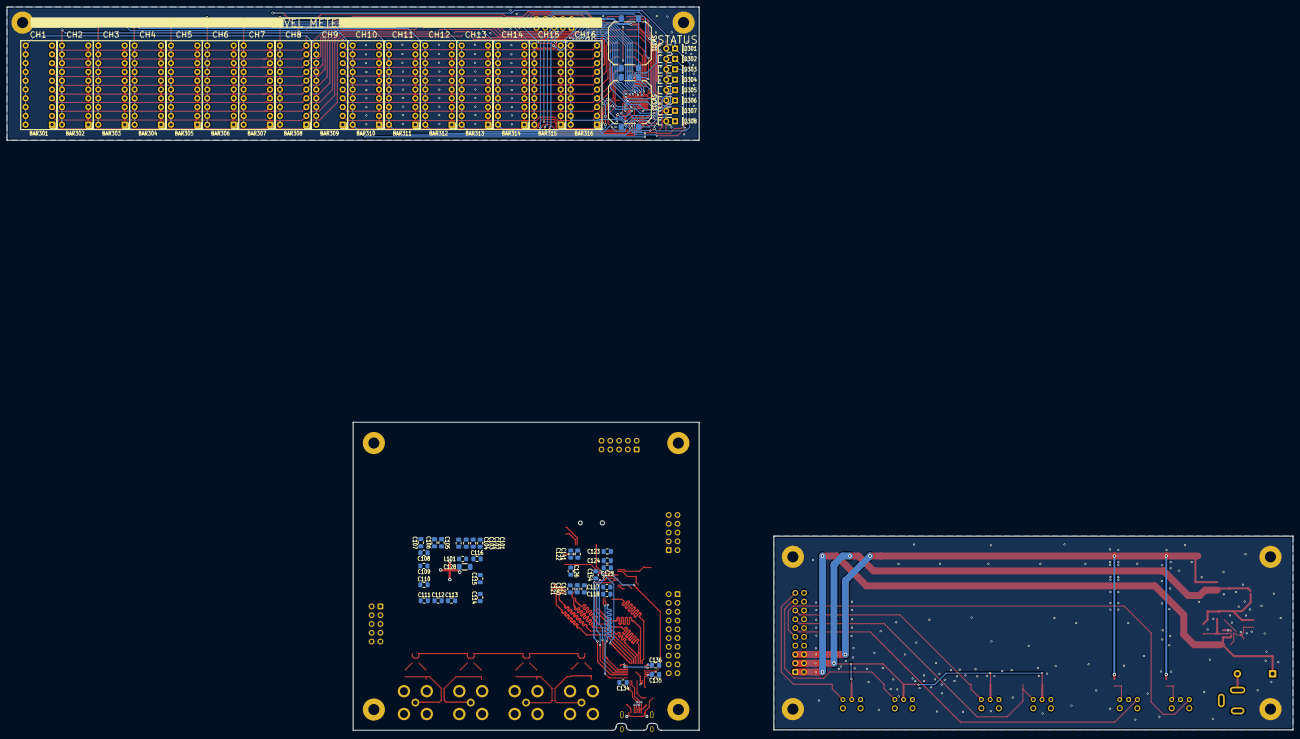
[picture p35: board adatv2.kicad_pcb from below]

Board: 4 copper layers, 371.6 x 209.0 mm, 237 parts (59 on the bottom side), 201 nets.
