swiszczoo/adat_usb_interface/cubemx/cubemx.ioc

Mcu.UserName=STM32F427VGTx
PA10.GPIO_Label=ADAT_OUT2_USER1
PA10.Signal=GPIO_Output
PA11.GPIO_Label=ADAT_OUT2_USER2
PA11.Signal=GPIO_Output
PA12.GPIO_Label=ADAT_OUT2_USER3
PA12.Signal=GPIO_Output
PA13.Signal=SYS_JTMS-SWDIO
PA14.Signal=SYS_JTCK-SWCLK
PA3.Signal=USB_OTG_HS_ULPI_D0
PA4.Signal=I2S3_WS
PA5.Signal=USB_OTG_HS_ULPI_CK
PA8.Signal=RCC_MCO_1
PA9.GPIO_Label=ADAT_OUT2_USER0
PA9.Signal=GPIO_Output
PB0.Signal=USB_OTG_HS_ULPI_D1
PB1.Signal=USB_OTG_HS_ULPI_D2
PB10.Signal=USB_OTG_HS_ULPI_D3
PB11.Signal=USB_OTG_HS_ULPI_D4
PB12.Signal=USB_OTG_HS_ULPI_D5
PB13.Signal=USB_OTG_HS_ULPI_D6
PB14.Signal=I2S2_ext_SD
PB15.Signal=I2S2_SD
PB3.Signal=SYS_JTDO-SWO
PB5.Signal=USB_OTG_HS_ULPI_D7
PB6.Signal=I2C1_SCL
PB7.Signal=I2C1_SDA
PB9.Signal=I2S2_WS
PC0.Signal=USB_OTG_HS_ULPI_STP
PC10.Signal=I2S3_CK
PC11.Signal=I2S3_ext_SD
PC12.Signal=I2S3_SD
PC2.Signal=USB_OTG_HS_ULPI_DIR
PC3.Signal=USB_OTG_HS_ULPI_NXT
PC5.GPIO_Label=SW_SAMPLERATE
PC5.Signal=GPIO_Input
PC6.GPIO_Label=SW_LOOPBACK
PC6.Signal=GPIO_Input
PC9.Signal=I2S_CKIN
PD10.GPIO_Label=I2S_RESYNC_REQ
PD10.Signal=GPIO_Output
PD11.GPIO_Label=I2S_RUNNING
PD11.Signal=GPIO_Input
PD12.GPIO_Label=ADAT1_LOCKED
PD12.Signal=GPIO_Input
PD13.GPIO_Label=ADAT2_LOCKED
PD13.Signal=GPIO_Input
PD14.GPIO_Label=LOOPBACK
PD14.Signal=GPIO_Output
PD3.Signal=I2S2_CK
PD5.GPIO_Label=FPGA_STATUS
PD5.Signal=GPIO_Input
PD6.GPIO_Label=FPGA_CONF_DONE
PD6.Signal=GPIO_Input
PD7.GPIO_Label=MCU_READY
PD7.Signal=GPIO_Output
PD8.GPIO_Label=FS_SEL
PD8.Signal=GPIO_Output
PD9.GPIO_Label=FPGA_PLL_LOCKED
PD9.Signal=GPIO_Input
PE0.GPIO_Label=MCU_DEBUG0
PE0.Signal=GPIO_Output
PE1.GPIO_Label=MCU_DEBUG1
PE1.Signal=GPIO_Output
PE10.GPIO_Label=ADAT_IN2_USER2
PE10.Signal=GPIO_Input
PE11.GPIO_Label=ADAT_IN2_USER3
PE11.Signal=GPIO_Input
PE12.GPIO_Label=ADAT_OUT1_USER0
PE12.Signal=GPIO_Output
PE13.GPIO_Label=ADAT_OUT1_USER1
PE13.Signal=GPIO_Output
PE14.GPIO_Label=ADAT_OUT1_USER2
PE14.Signal=GPIO_Output
PE15.GPIO_Label=ADAT_OUT1_USER3
PE15.Signal=GPIO_Output
PE2.GPIO_Label=MCU_DEBUG2
PE2.Signal=GPIO_Output
PE3.GPIO_Label=MCU_DEBUG3
PE3.Signal=GPIO_Output
PE4.GPIO_Label=ADAT_IN1_USER0
PE4.Signal=GPIO_Input
PE5.GPIO_Label=ADAT_IN1_USER1
PE5.Signal=GPIO_Input
PE6.GPIO_Label=ADAT_IN1_USER2
PE6.Signal=GPIO_Input
PE7.GPIO_Label=ADAT_IN1_USER3
PE7.Signal=GPIO_Input
PE8.GPIO_Label=ADAT_IN2_USER0
PE8.Signal=GPIO_Input
PE9.GPIO_Label=ADAT_IN2_USER1
PE9.Signal=GPIO_Input
PH0/OSC_IN.Signal=RCC_OSC_IN
PH1/OSC_OUT.Signal=RCC_OSC_OUT
