swiszczoo/adat_usb_interface/hdl/modules/nrzi_encoder.sv

module nrzi_encoder (
    input           clk_i,
    input           data_i,
    input           output_en_i,
    output          data_o
);
    var bit output_state_r = '0;
    logic output_state_next;
    
    var bit output_en_r = '0;
    logic output_en_next;

    always_comb begin
        output_state_next = output_state_r ^ data_i;
        output_en_next = output_en_i;
    end

    always_ff @(posedge clk_i) begin
        output_state_r <= output_state_next;
        output_en_r <= output_en_next;
    end

    assign data_o = output_state_r && output_en_r;
endmodule
