swiszczoo/adat_usb_interface/hdl/tb/adat_decoder_tb.sv

`include "../ip/fifo_dual_clock.v"
`include "../modules/adat_decoder.sv"
`include "../modules/channel_buffer.sv"
`include "jitter_generator.sv"

`timescale 10ns / 1ns
module adat_decoder_tb (
    output          clk_o,
    output          clk_x4_o,
    output reg      adat_in_o,
    output          ram_write_en_o,
    output [10:0]   ram_write_addr_o,
    output          ram_write_data_o,
    output [2:0]    last_good_frame_idx_o,
    output [3:0]    user_bits_o,
    output          has_sync_o
);
    var bit clk_state_r = '0;
    var bit clk_state_x4_r = '0;
    var bit adat_state_r = '0;
    var bit reset_state_r = '0;

    assign clk_o = clk_state_r;
    assign clk_x4_o = clk_state_x4_r;

    adat_decoder #(
        .CIRC_BUF_BITS              (3)
    ) u_adat_decoder (
        .clk_i                      (clk_state_r),
        .clk_x4_i                   (clk_state_x4_r),
        .nrzi_i                     (adat_state_r),
        .reset_i                    (reset_state_r),
        .ram_write_en_o             (ram_write_en_o),
        .ram_write_addr_o           (ram_write_addr_o),
        .ram_write_data_o           (ram_write_data_o),
        .last_good_frame_idx_o      (last_good_frame_idx_o),
        .user_bits_o                (user_bits_o),
        .has_sync_o                 (has_sync_o)
    );

    var bit [10:0] ram_read_addr = '0;
    bit ram_data;

    channel_buffer u_channel_buffer (
        .write_data_i               (ram_write_data_o),
        .read_addr_i                (ram_read_addr),
        .write_addr_i               (ram_write_addr_o),
        .wr_en_i                    (ram_write_en_o),
        .clk_i                      (clk_state_r),
        .read_data_o                (ram_data)
    );

    var bit [2047:0] adat_in;
    var bit [2047:0] i2s_out;
    const real jitter_amount = 2.0;

    // x4 clock process
    initial begin
        forever begin
            clk_state_x4_r = '1;
            #1;
            clk_state_x4_r = '0;
            #1;
        end
    end
    
    // System clock process
    initial begin
        forever begin
            clk_state_r = '1;
            #4;
            clk_state_r = '0;
            #4;
        end
    end

    // Load data process
    int fd, status;
    initial begin
        fd = $fopen("../../tb/adat_test_data_adat_nrzi.bin", "rb");
        status = $fread(adat_in, fd);
        $fclose(fd);

        fd = $fopen("../../tb/adat_test_data_i2s.bin", "rb");
        status = $fread(i2s_out, fd);
        $fclose(fd);
    end

    // Test process
    jitter_generator gen = new();
    bit ok = 1'b1;

    initial begin
        gen.initialize();

        for (int i = 0; i < 2048; i++) begin
            adat_state_r = adat_in[2047 - i];

            if (i > 150) begin
                gen.jitter(jitter_amount);
            end else begin
                gen.jitter(real'(150 - i) / 20.0 + 1.0);
            end
        end

        #256;

        // skip first adat frame
        i2s_out = i2s_out << 256;

        for (int i = 0; i < 2048; i++) begin
            if (i2s_out[2047 - i] != u_channel_buffer.u_simple_dual_port_ram_single_clock.ram[i]) begin
                $display("Invalid bit at pos %d", i);
                ok = 1'b0;
            end
        end

        if (ok) begin
            $display("Everything is ok!");
        end else begin
            $display("Something is wrong!");
            $display("Expected content in RAM:");
            $display("%b", i2s_out);

            for (int i = 0; i < 2048; i++) begin
                i2s_out[2047 - i] = u_channel_buffer.u_simple_dual_port_ram_single_clock.ram[i];
            end
            
            $display("Actual content in RAM:");
            $display("%b", i2s_out);
        end

        $stop;
    end

    assign adat_in_o = adat_state_r;
endmodule
