swiszczoo/adat_usb_interface/hdl/ip/pll_inst.v

pll	pll_inst (
	.areset ( areset_sig ),
	.clkswitch ( clkswitch_sig ),
	.inclk0 ( inclk0_sig ),
	.inclk1 ( inclk1_sig ),
	.activeclock ( activeclock_sig ),
	.c0 ( c0_sig ),
	.c1 ( c1_sig ),
	.c2 ( c2_sig ),
	.locked ( locked_sig )
	);
