swiszczoo/adat_usb_interface/hdl/ip/fifo_dual_clock_inst.v

fifo_dual_clock	fifo_dual_clock_inst (
	.data ( data_sig ),
	.rdclk ( rdclk_sig ),
	.rdreq ( rdreq_sig ),
	.wrclk ( wrclk_sig ),
	.wrreq ( wrreq_sig ),
	.q ( q_sig ),
	.rdempty ( rdempty_sig ),
	.wrfull ( wrfull_sig )
	);
