swiszczoo/adat_usb_interface/hdl/modules/simple_dual_port_ram_single_clock.sv

// Quartus Prime Verilog Template
// Simple Dual Port RAM with separate read/write addresses and
// single read/write clock

module simple_dual_port_ram_single_clock
#(parameter DATA_WIDTH=8, parameter ADDR_WIDTH=6)
(
    input [(DATA_WIDTH-1):0] data,
    input [(ADDR_WIDTH-1):0] read_addr, write_addr,
    input we, clk,
    output reg [(DATA_WIDTH-1):0] q
);
    // Declare the RAM variable
    (* ramstyle = "M9K" *) reg [DATA_WIDTH-1:0] ram[2**ADDR_WIDTH-1:0];

    // M9K blocks are guaranteed to be initialized to zero in hardware
    `ifdef SIMULATION
        initial begin
            $display("Set ram contents to zero");
            for (int i = 0; i < 2**ADDR_WIDTH; i++) begin
                ram[i] = '0;
            end
        end
    `endif

    always @ (posedge clk) begin
        // Write
        if (we)
            ram[write_addr] <= data;

        // Read (if read_addr == write_addr, return OLD data).	To return
        // NEW data, use = (blocking write) rather than <= (non-blocking write)
        // in the write assignment.	 NOTE: NEW data may require extra bypass
        // logic around the RAM.
        q <= ram[read_addr];
    end

endmodule
