swiszczoo/adat_usb_interface/(commit log)

2025-09-04 Fix NRZI decoder design
    [nrzi_phase_lock_decoder.sv, nrzi_phase_lock_decoder_tb.sv]
2025-09-06 Fix adat_decoder to synthesize
    [adat_decoder.sv]
2025-09-07 Write testbench and fix adat_decoder module
    [adat_decoder.sv, adat_decoder_tb.sv, channel_buffer.sv, jitter_generator.sv, nrzi_phase_lock_decoder_tb.sv]
2025-09-09 Write testbench and fix i2s_msb_transmitter
    [i2s_msb_transmitter.sv, i2s_msb_transmitter_tb.sv]
2025-09-28 Further schematic capture
    [adatv2.kicad_sch, fpga.kicad_sch, io.kicad_sch, io_board.kicad_sch, main_board.kicad_sch, power_supply.kicad_sch]
2025-09-30 Assign most of the footprints to schematic components
    [adatv2.kicad_pcb, adatv2.kicad_sch, display_board.kicad_sch, fpga.kicad_sch, io.kicad_sch, io_board.kicad_sch, main_board.kicad_sch, peripherals.kicad_sch]
2025-10-01 Finish assigning footprints to project
    [adatv2.kicad_pcb, display_board.kicad_sch, fpga.kicad_sch, io.kicad_sch, io_board.kicad_sch, main_board.kicad_sch, peripherals.kicad_sch, power_supply.kicad_sch]
2025-10-03 Finish drawing IO/Supply board
    [adatv2.kicad_pcb, display_board.kicad_sch, fpga.kicad_sch, io.kicad_sch, io_board.kicad_sch, main_board.kicad_sch, peripherals.kicad_sch, power_supply.kicad_sch]
2025-10-04 Draw first version of display board
    [adatv2.kicad_pcb, display_board.kicad_sch]
2025-10-04 Small display board layout improvements
    [adatv2.kicad_pcb]
2025-10-09 Add missing CAD models of I/O electronic components
    [CUI_PJ002A.FCStd, CUI_PJ002A.step, DOSIN_801_0051.FCStd, DOSIN_801_0051.step, PLx237.FCStd, PLx237.step, adatv2.kicad_pcb, fpga.kicad_sch]
2025-10-10 Start routing main board
    [adatv2.kicad_pcb, power_supply.kicad_sch]
2025-10-12 Finish first revision of main pcb
    [fpga.kicad_sch, power_supply.kicad_sch]
2025-10-12 Add buffers for ADAT transfer
    [io.kicad_sch, io_board.kicad_sch, power_supply.kicad_sch]
2025-10-12 Assign FPGA pins, change MCU to STM32F429VET6
    [io.kicad_sch, io_board.kicad_sch, main_board.kicad_sch, peripherals.kicad_sch, power_supply.kicad_sch]
2025-10-23 Add PCB production files
    [display-board-B_Cu.gbl, display-board-B_Mask.gbs, display-board-B_Paste.gbp, display-board-B_Silkscreen.gbo, display-board-Edge_Cuts.gm1, display-board-F_Cu.gtl, display-board-F_Mask.gts, display-board-F_Paste.gtp]
2025-10-23 Provide final rev 1.0a production files
    [display-board-B_Cu.gbl, display-board-B_Mask.gbs, display-board-B_Paste.gbp, display-board-B_Silkscreen.gbo, display-board-Edge_Cuts.gm1, display-board-F_Cu.gtl, display-board-F_Mask.gts, display-board-F_Paste.gtp]
2025-11-04 Design bottom plate in cad
    [V-Slot 20x40x500 Linear Rail.step, assembly.FCStd, bottom_plate.FCStd, display-board.step, supply-board.step, vslot_2040_250.FCStd]
2025-11-04 Switch assembly workbench to A2plus
    [assembly.FCStd]
2025-11-04 Add PCB standoffs to CAD assembly
    [Tee Nut.step, assembly.FCStd, main-board.FCStd, spacer_10+6.FCStd, supply-board.FCStd, tee_nut.FCStd]
2025-11-04 Design front and top plate in CAD
    [assembly.FCStd, bottom_plate.FCStd, display-board.FCStd, front_plate.FCStd, top_plate.FCStd]
2025-11-06 Close enclosure by adding back plate in CAD
    [assembly.FCStd, back_plate.FCStd, front_plate.FCStd]
2025-11-23 Add pin assignment to cubemx project
2025-11-25 Add unfinished front acrylic design
    [assembly.FCStd, back_plate.FCStd, bottom_plate.FCStd, front_acrylic.FCStd, front_plate.FCStd]
